14MM47/reading_light/deliverable/07-design-reference/images/moon-lithophane-preview.png

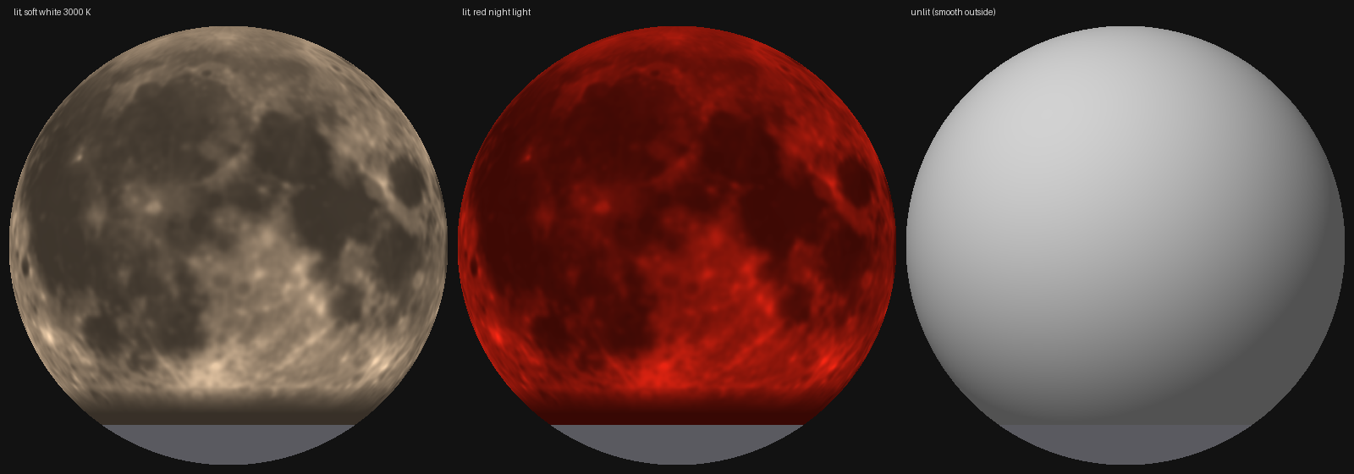
deliverable/07-design-reference/images/moon-lithophane-preview.png
