14MM47/reading_light/deliverable/07-design-reference/README.md

# 07: Design reference

- `led-board-v0.2-and-slim-head-design-note.pdf`: why the LP5012 and the MCP9800, the 18 mm layout, the optics
  correction, the slim head, what changes for the user, cost.
- `electronics-design-notes.pdf`: power path, charger, LED drive, thermal protection, runtimes, I²C.
- `datasheet-key-specs.pdf`: the datasheet values the design relies on, with page references.
- `research-*.pdf`: light modes (melanopic guidance, colour targets), Farnell/RS sourcing, gooseneck, battery and
  PCB pricing.
- `optics/`: `head_v02.py` and its output `head_v02.txt` (v0.2 head, the opening as the aperture), and the round-1
  integrating-sphere results `sphere_illum.*`.
- `handoff-06-thingiverse-survey.pdf`: survey of existing moon models. Not done from the cloud, because the site's
  bot protection blocks automated access.
- `images/moon-lithophane-preview.png`: the NASA-data lithophane, lit.
