14MM47/reading_light/deliverable/07-design-reference/optics/sphere_illum.csv

opening_deg | board_z_mm | dz_mm | max_over_min | flux_to_wall
25.0 | -25.39 | -4.0 | 1.352 | 0.791
25.0 | -24.39 | -3.0 | 1.228 | 0.848
25.0 | -23.39 | -2.0 | 1.062 | 0.91
25.0 | -22.39 | -1.0 | 1.01 | 0.975
25.0 | -21.39 | 0.0 | 1.015 | 1.0
25.0 | -19.89 | 1.5 | 1.393 | 1.0
25.0 | -18.39 | 3.0 | 1.999 | 1.0
25.0 | -15.39 | 6.0 | 2.151 | 1.0
25.0 | -11.39 | 10.0 | 2.413 | 1.0
30.0 | -24.44 | -4.0 | 1.12 | 0.838
30.0 | -23.44 | -3.0 | 1.036 | 0.896
30.0 | -22.44 | -2.0 | 1.005 | 0.95
30.0 | -21.44 | -1.0 | 1.003 | 0.988
30.0 | -20.44 | 0.0 | 1.074 | 1.0
30.0 | -18.94 | 1.5 | 1.427 | 1.0
30.0 | -17.44 | 3.0 | 2.046 | 1.0
30.0 | -14.44 | 6.0 | 2.208 | 1.0
30.0 | -10.44 | 10.0 | 2.49 | 1.0
