14MM47/reading_light/deliverable/00-overview/fitment/fitment_sheet.png

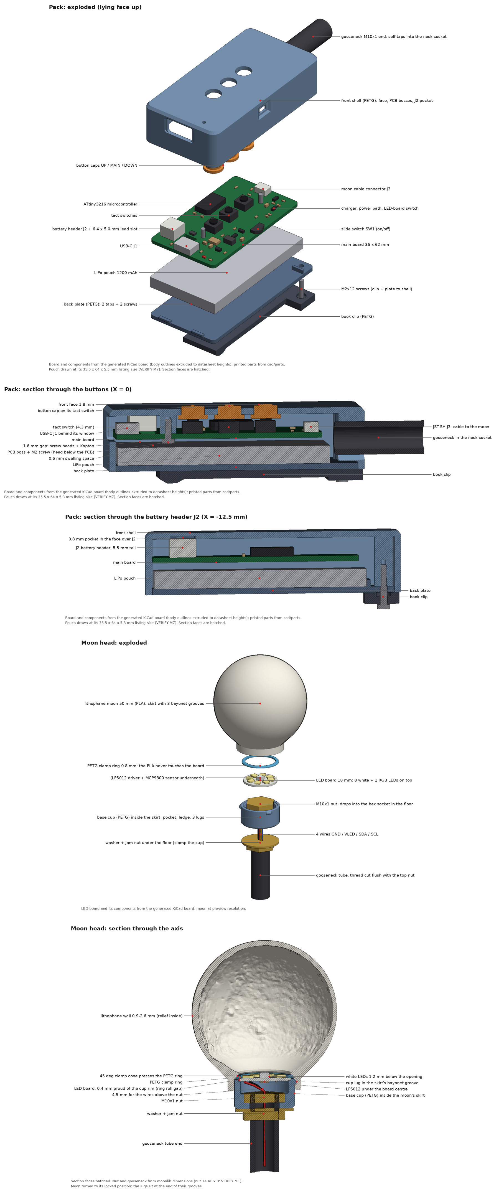
deliverable/00-overview/fitment/fitment_sheet.png
