14MM47/reading_light/deliverable/00-overview/fitment/head_exploded.png

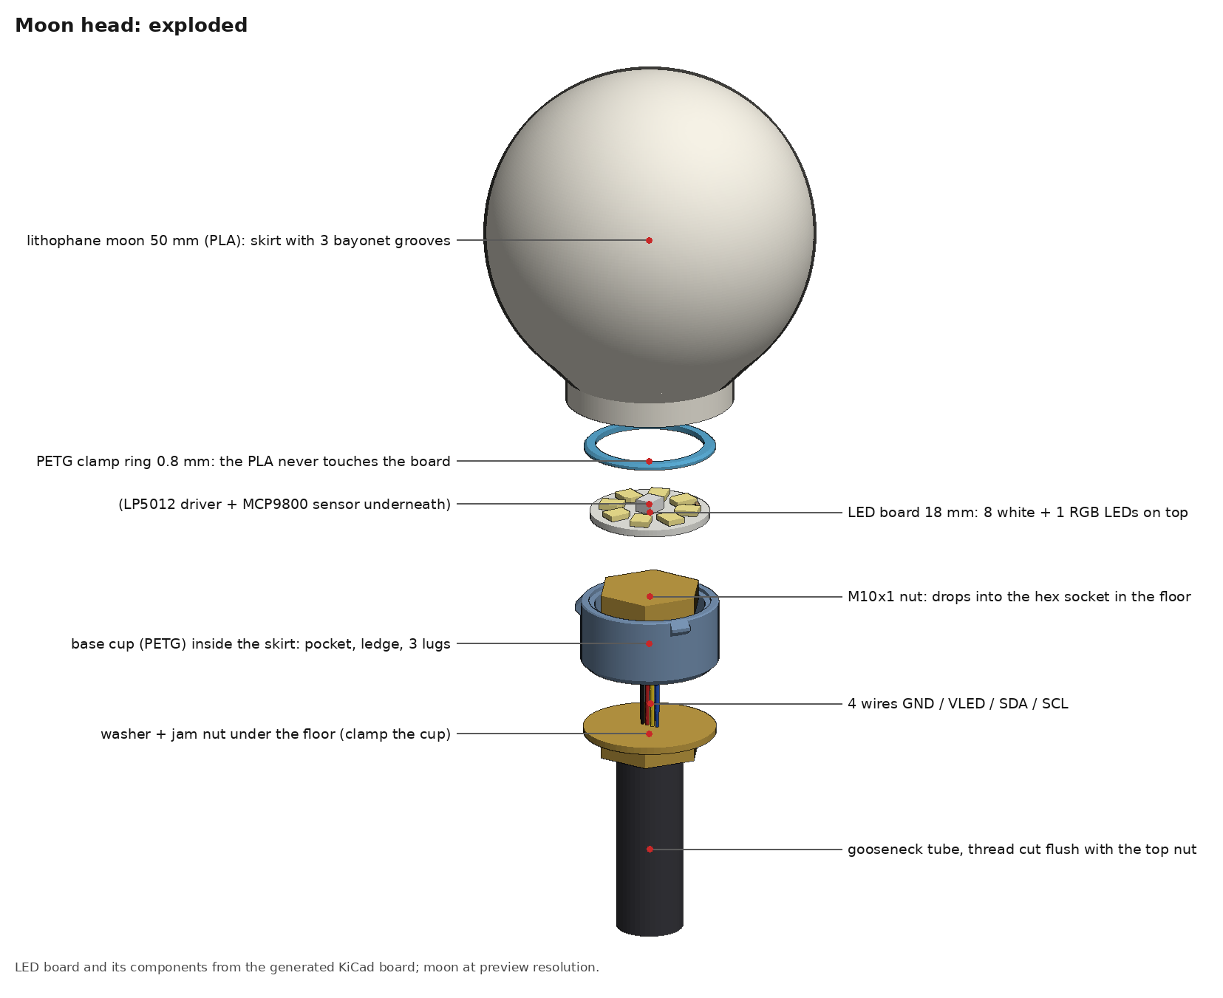
deliverable/00-overview/fitment/head_exploded.png
