14MM47/reading_light/deliverable/00-overview/fitment/pack_section_buttons.png

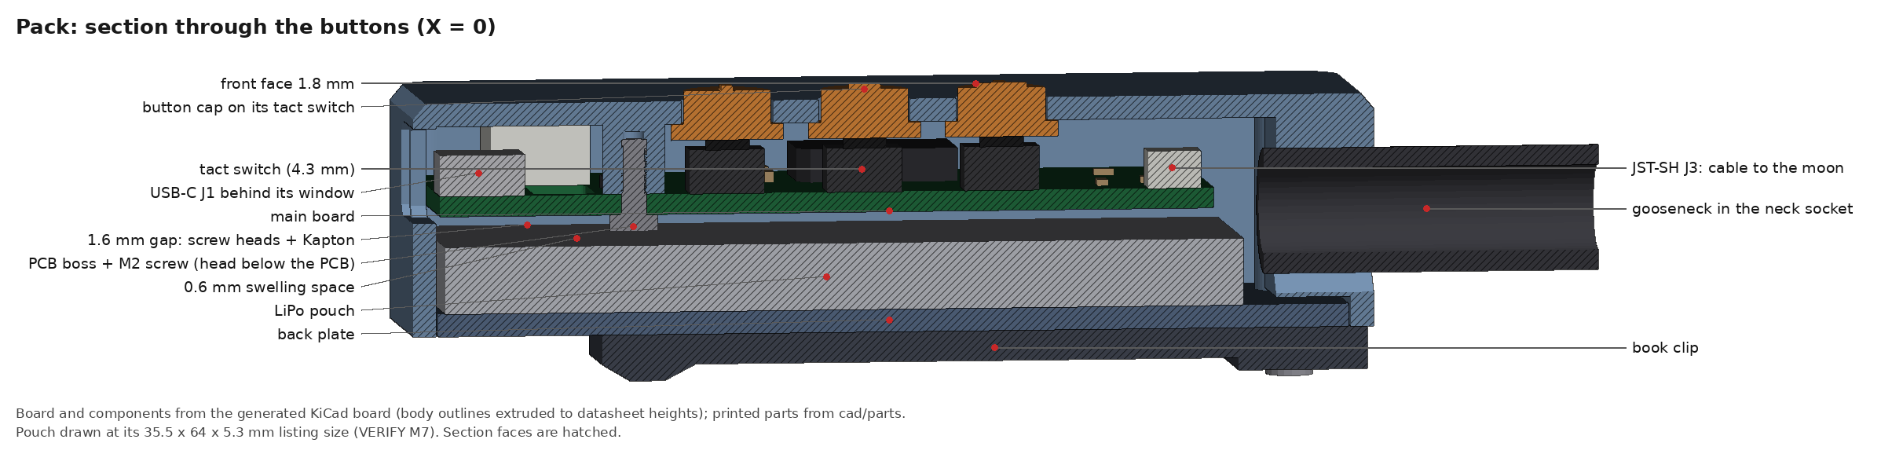
deliverable/00-overview/fitment/pack_section_buttons.png
