14MM47/reading_light/fab/led-board/v0.2/renders/led-board_bottom.png

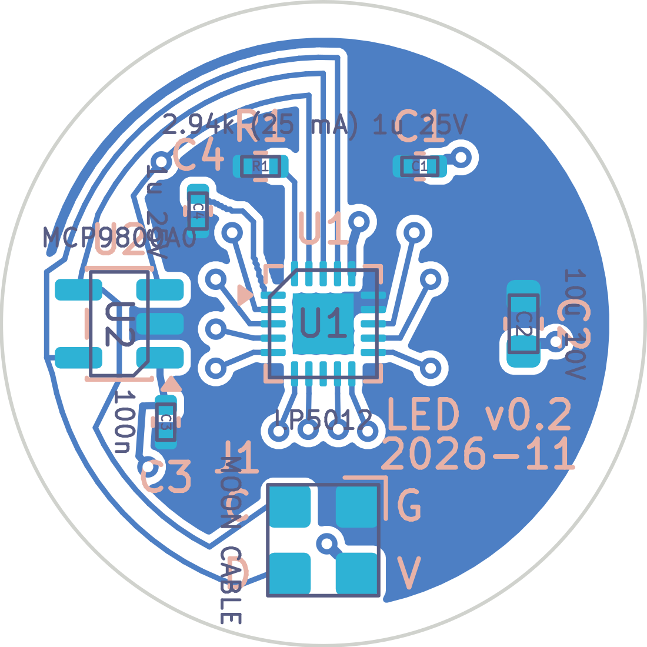
fab/led-board/v0.2/renders/led-board_bottom.png
