14MM47/reading_light/bom/BOM.csv

Key | Qty per lamp | References | Value | Manufacturer | MPN | Description | Footprint | Farnell | Datasheet
USBC | 1 | main:J1 | USB4125-GF-A | GCT | USB4125-GF-A | USB-C receptacle, 6-pin power only, top mount, SMT + THT shell | USB_C_Receptacle_GCT_USB4125-xx-x_6P_TopMnt_Horizontal | 3648642 | https://gct.co/files/drawings/usb4125.pdf
PTC | 1 | main:F1 | 1.1A PTC | Bourns | MF-MSMF110/16X-2 | Resettable fuse 1.1 A hold / 2.2 A trip, 16 V, 0.06-0.20 Ohm, 1812 (VBUS: limits a short in the neck cable on USB; 0.75 A part had too little hold margin when warm, round2 R2-E3) | Fuse_1812_4532Metric |  | https://www.bourns.com/docs/Product-Datasheets/mf-msmf.pdf
R_5K1 | 2 | main:R1 main:R2 | 5.1k | Multicomp Pro | MCWR06X5101FTL | Resistor 5.1 kOhm 1% 0603 | R_0603_1608Metric
TVS | 1 | main:D1 | SMF5.0A | Littelfuse | SMF5.0A | TVS unidirectional 5.0 V standoff, 200 W, SOD-123FL | D_SOD-123F | 2691565 | https://www.littelfuse.com/products/tvs-diodes/surface-mount/smf.aspx
C_10U | 4 | main:C1 main:C2 main:C3 main:C4 | 10u 16V 0805 | Samsung | CL21A106KOQNNNE | MLCC 10 uF 16 V X5R 0805 (0603 10 V part keeps only 2.9 uF at 5 V) | C_0805_2012Metric
CHG | 1 | main:U1 | MCP73831-2ACI/OT | Microchip | MCP73831T-2ACI/OT | Li-ion/LiPo linear charger 4.20 V, up to 500 mA, SOT-23-5 | SOT-23-5 | 1332158 | https://ww1.microchip.com/downloads/aemDocuments/documents/APID/ProductDocuments/DataSheets/MCP73831-Family-Data-Sheet-DS20001984H.pdf
R_3K9 | 1 | main:R3 | 3.9k | Multicomp Pro | MCWR06X3901FTL | Resistor 3.9 kOhm 1% 0603 (charge current 256 mA) | R_0603_1608Metric
R_1K | 2 | main:R4 main:R11 | 1k | Multicomp Pro | MCWR06X1001FTL | Resistor 1 kOhm 1% 0603 | R_0603_1608Metric
LED_RED_0603 | 1 | main:D2 | red | Kingbright | APT1608SURCK | Hyper-red chip LED 0603, 230 mcd @ 20 mA, pin 1 = K (charge indicator, ~3 mA) | LED_0603_1608Metric |  | https://www.kingbrightusa.com/images/catalog/SPEC/APT1608SURCK.pdf
JST_PH2 | 1 | main:J2 | S2B-PH-SM4-TB | JST | S2B-PH-SM4-TB(LF)(SN) | JST PH 2-pin side-entry SMD header (battery) | JST_PH_S2B-PH-SM4-TB_1x02-1MP_P2.00mm_Horizontal | 9492615
PFET | 4 | main:Q3 main:Q1 main:Q2 main:Q4 | DMG2305UX | Diodes Inc | DMG2305UX-7 | P-MOSFET -20 V -4.2 A, Rds(on) 52 mOhm @ -4.5 V (max), SOT-23 (G=1 S=2 D=3) | SOT-23 | 2543533 | https://www.diodes.com/assets/Datasheets/DMG2305UX.pdf
R_10K | 4 | main:R10 main:R5 main:R7 main:R13 | 10k | Multicomp Pro | MCWR06X1002FTL | Resistor 10 kOhm 1% 0603 | R_0603_1608Metric | 2447230
RECT | 1 | main:D3 | S1J | Vishay | S1J-E3/61T | Silicon rectifier 1 A 600 V, SMA (DO-214AC); Vf ~0.85 V @ 0.3 A; leakage nA at 4 V reverse (USB -> VSYS OR-ing) | D_SMA |  | https://www.vishay.com/docs/88711/s1a.pdf
R_1M | 1 | main:R6 | 1M | Multicomp Pro | MCWR06X1004FTL | Resistor 1 MOhm 1% 0603 | R_0603_1608Metric
C_100N | 3 | main:C5 main:C6 main:C8 | 100n | Multicomp Pro | MC0603B104K500CT | MLCC 100 nF 50 V X7R 0603 | C_0603_1608Metric | 1759122
SLIDE | 1 | main:SW1 | PCM12SMTR | C&K | PCM12SMTR | Mini slide switch SPDT, right-angle SMD (side actuated) | SW_SPDT_PCM12 | 9575146
MCU | 1 | main:U2 | ATtiny3216-SN | Microchip | ATTINY3216-SN | 8-bit AVR MCU, 32 KB flash, 256 B EEPROM, UPDI, 1.8-5.5 V, SOIC-20 (300 mil) | SOIC-20W_7.5x12.8mm_P1.27mm | 3018703 | https://ww1.microchip.com/downloads/aemDocuments/documents/MCU08/ProductDocuments/DataSheets/ATtiny3216-17-DataSheet-DS40002205A.pdf
C_1U | 1 | main:C7 | 1u | Samsung | CL10A105KB8NNNC | MLCC 1 uF 50 V X5R 0603 | C_0603_1608Metric | 3013385
TACT | 3 | main:SW2 main:SW3 main:SW4 | PTS645SM43SMTR92 | C&K | PTS645SM43SMTR92 LFS | Tactile switch 6x6x4.3 mm SMD, 160 gf | SW_SPST_PTS645Sx43SMTR92 | 3941596
R_100K | 1 | main:R12 | 100k | Multicomp Pro | MCWR06X1003FTL | Resistor 100 kOhm 1% 0603 | R_0603_1608Metric
R_3K3 | 2 | main:R8 main:R9 | 3.3k | Multicomp Pro | MCWR06X3301FTL | Resistor 3.3 kOhm 1% 0603 (I2C pull-up) | R_0603_1608Metric
JST_SH4 | 1 | main:J3 | SM04B-SRSS-TB | JST | SM04B-SRSS-TB(LF)(SN) | JST SH 4-pin side-entry SMD header (Qwiic pinout, moon cable) | JST_SH_SM04B-SRSS-TB_1x04-1MP_P1.00mm_Horizontal | 1830839
LED_WW | 4 | led:D1 led:D3 led:D5 led:D7 | 2700K CRI97 | Bridgelux | BXEN-27S-11M-3C-00-0-3 | Mid-power white LED 2835, 2700 K, CRI 97 (Thrive), 3 V class | LED_PLCC_2835_Dense | 3498849
LED_CW | 4 | led:D2 led:D4 led:D6 led:D8 | 5000K CRI97 | Bridgelux | BXEN-50S-11M-3C-00-0-3 | Mid-power white LED 2835, 5000 K, CRI 97 (Thrive), 3 V class | LED_PLCC_2835_Dense | 3498853
LED_RGB | 1 | led:D9 | RGB 3528 CA | Wurth Elektronik | 150141M173100 | RGB LED PLCC-4 3528, common anode (1 A, 2 B-K, 3 R-K, 4 G-K), 30 mA max/die, R 625 / G 520 / B 470 nm | LED_RGB_Wuerth-PLCC4_3.2x2.8mm_150141M173100 | 2322115 | https://www.we-online.com/components/products/datasheet/150141M173100.pdf
LEDDRV | 1 | led:U1 | LP5012RUKR | Texas Instruments | LP5012RUKR | 12-ch I2C constant-current RGB LED sink driver, 25.5 mA max, 12-bit (9+3 dither) 29 kHz PWM, WQFN-20 3x3 0.4 mm pitch | Texas_RUK0020B_WQFN-20-1EP_3x3mm_P0.4mm_EP1.7x1.7mm |  | https://www.ti.com/lit/ds/symlink/lp5012.pdf
R_2K94_0402 | 1 | led:R1 | 2.94k | Yageo | RC0402FR-072K94L | Resistor 2.94 kOhm 1% 0402 (LP5012 RIREF: 105 x 0.7 V / 2.94 k = 25.0 mA/channel) | R_0402_1005Metric
C_1U_0402 | 2 | led:C1 led:C4 | 1u 25V | Murata | GRM155R61E105KA12D | MLCC 1 uF 25 V X5R 0402 (LP5012 VCC / VCAP) | C_0402_1005Metric
C_10U_0603 | 1 | led:C2 | 10u 10V | Murata | GRM188R61A106KE69D | MLCC 10 uF 10 V X5R 0603 (LED board bulk) | C_0603_1608Metric
TEMP | 1 | led:U2 | MCP9800A0 | Microchip | MCP9800A0T-M/OT | I2C temperature sensor, LM75 register compatible (8-bit CONFIG), address 0x48, 2.7-5.5 V, open-drain ALERT, +/-0.5 C typ, +/-1 C max (-10..85 C), SOT-23-5 | SOT-23-5 | 1439485 | https://ww1.microchip.com/downloads/en/DeviceDoc/21909d.pdf
R_2K4_0402 | 1 | led:R2 | 2.4k | Yageo | RC0402FR-072K4L | Resistor 2.4 kOhm 1% 0402 (LP5012 EN pull-up) | R_0402_1005Metric
C_100N_0402 | 1 | led:C3 | 100n | Murata | GRM155R71C104KA88D | MLCC 100 nF 16 V X7R 0402 | C_0402_1005Metric
OTHER | 1 |  |  | Pimoroni | BAT0004 | LiPo pouch 3.7 V 1200 mAh, protected, JST-PH 2.0 lead (64 x 35.5 x 5.3 mm) |  |  | https://shop.pimoroni.com/products/lipo-battery-pack
OTHER | 1 |  |  | Amazon UK (PATIKIL 4.7in M10 gooseneck) | search: PATIKIL gooseneck M10 120mm | Gooseneck 120 mm, 10 mm OD, M10x1 male ends, hollow (6.8 mm bore)
OTHER | 1 |  |  | Amazon UK / eBay (food-grade silicone tube) | 10x12mm silicone tube 1 m | Silicone tube 10 mm ID x 12 mm OD, 150 mm (sleeve for the gooseneck: the plastic-coated finish)
OTHER | 2 |  |  | Lamp Spares UK / any lamp-parts shop | M10x1 lamp nut | M10x1 brass hex nut, ~14 mm AF, 3 mm thick (moon base: one in the cup's socket, one jam nut under the floor)
OTHER | 1 |  |  | Lamp Spares UK / Accu.co.uk | M10 washer (lamp) or M10 form A | M10 flat washer, <= 20 mm OD, ~1 mm thick (under the cup floor, above the jam nut)
OTHER | 1 |  |  | RS Components | 288-4665 (SparkFun KIT-15081 Qwiic cable kit, 50-500 mm) | Qwiic / STEMMA QT 4-pin JST-SH cable >= 200 mm (cut one end; bare end solders to the LED board) |  |  | https://uk.rs-online.com/web/p/cable-assemblies/2884665
OTHER | 2 |  |  | Amazon/Accu.co.uk | M2x6 self tapping pan head A2 | M2 x 6 mm self-tapping pan-head screws (PCB to front shell)
OTHER | 2 |  |  | Amazon/Accu.co.uk | M2x12 self tapping pan head A2 | M2 x 12 mm self-tapping pan-head screws (clip + back plate to front shell)
OTHER | 1 |  |  | Bambu Lab (PLA Basic Jade White, PETG Basic) |  | Filament: white PLA (moon) ~12 g, PETG (base, pack, clip, caps) ~40 g
OTHER | 0 |  |  | any |  | Cyanoacrylate (super glue, gel) for the gooseneck ends and the LED-pad strain relief
OTHER | 0 |  |  | any |  | Neutral-cure silicone (or E6000): strain relief over the LED-board wire joints and the cable at J3
OTHER | 1 |  |  | Amazon UK / 3D-printer spares | PTFE tube 2x3mm | PTFE tube 2 mm ID x 3 mm OD (or silicone sleeve), 200 mm: protects the cable inside the gooseneck
OTHER | 0 |  |  | any |  | Kapton (polyimide) tape 10-20 mm: over the pouch under the PCB, under U1/D3/Q1-Q3, and a disc over the LED board's LP5012 (faces the gooseneck's metal end)
OTHER | 0 |  |  | any |  | USB-C charger >= 1 A at 5 V (if you don't have one)
