14MM47/reading_light/deliverable/02-parts-order/digikey_order.csv

Supplier | Order code / search | Manufacturer Part Number | Manufacturer | Quantity | Needed for builds | Indicative unit GBP (ex VAT) | Indicative line GBP | Description
DigiKey UK | LP5012RUKR (cut tape) - digikey.co.uk | LP5012RUKR | Texas Instruments | 3 | 2 | 0.900 | 2.70 | 12-ch I2C constant-current RGB LED sink driver, 25.5 mA max, 12-bit (9+3 dither) 29 kHz PWM, WQFN-20 3x3 0.4 mm pitch
