14MM47/reading_light/deliverable/01-pcb-manufacture/main-board/main-board.step

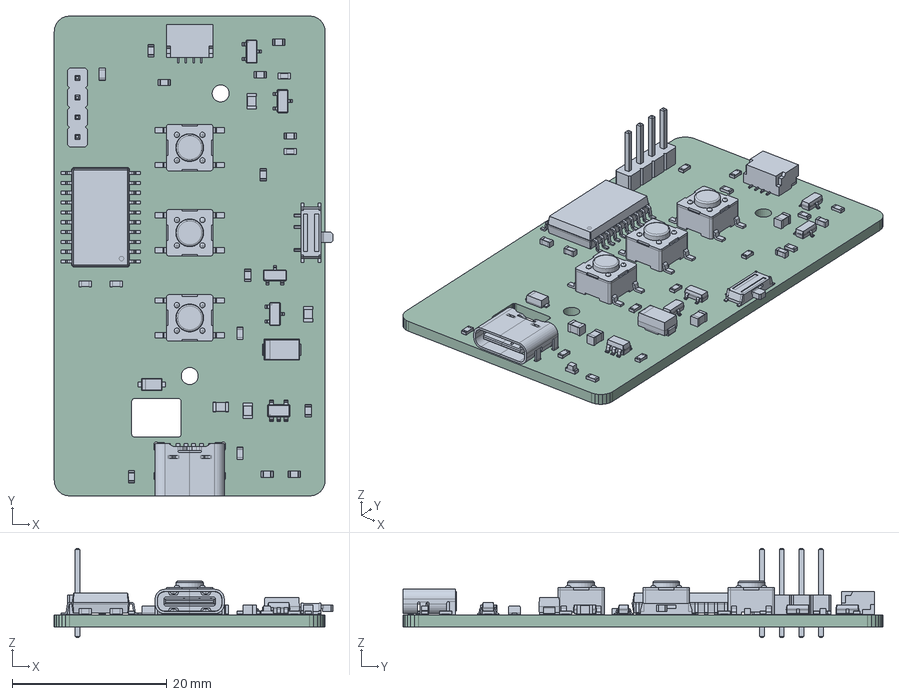
[picture p16: CAD file, 2026-11-02]
deliverable/01-pcb-manufacture/main-board/main-board.step
36.0 x 62.0 x 11.5 mm
SOT-23 x 4
C_0805_2012Metric x 4
SW_SPST_PTS645Sx43SMTR92 x 3
JST_SH_SM04B-SRSS-TB_1x04-1MP_P1.00mm_Horizontal
R_0603_1608Metric x 13
C_0603_1608Metric x 4
D_SMA
SW_SPDT_PCM12
SOIC-20W_7.5x12.8mm_P1.27mm
USB_C_Receptacle_GCT_USB4125-xx-x_6P_TopMnt_Horizontal
SOT-23-5
PinHeader_1x04_P2.54mm_Vertical
D_SOD-123F
LED_0603_1608Metric
main-board_PCB
