14MM47/reading_light/deliverable/01-pcb-manufacture/led-board/led-board.step

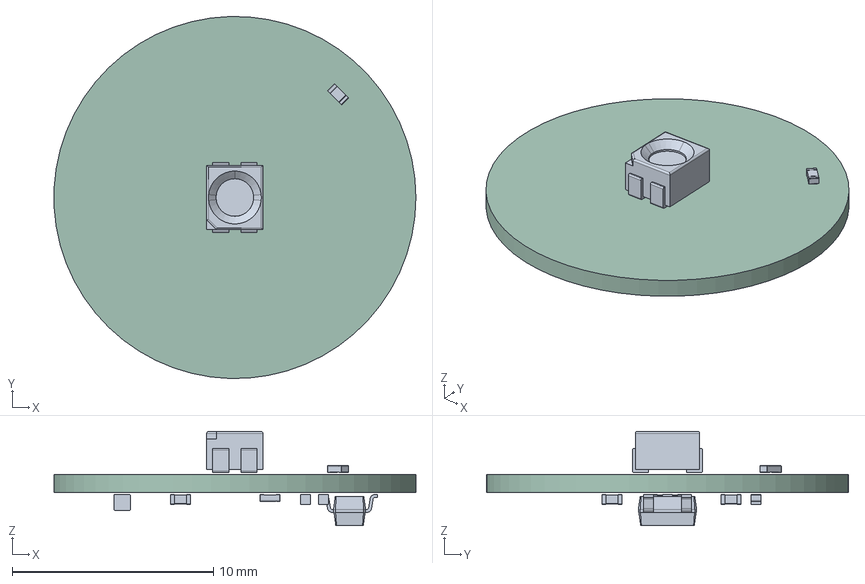
[picture p17: CAD file, 2026-11-04]
deliverable/01-pcb-manufacture/led-board/led-board.step
18.0 x 18.0 x 4.68 mm
R_0402_1005Metric x 2
LED_RGB_Wuerth-PLCC4_3.2x2.8mm_150141M173100
C_0603_1608Metric
C_0402_1005Metric x 3
SOT-23-5
led-board_PCB
