14MM47/reading_light/deliverable/03-3d-printing/1-coupons-print-first/coupon_litho_wedge.3mf

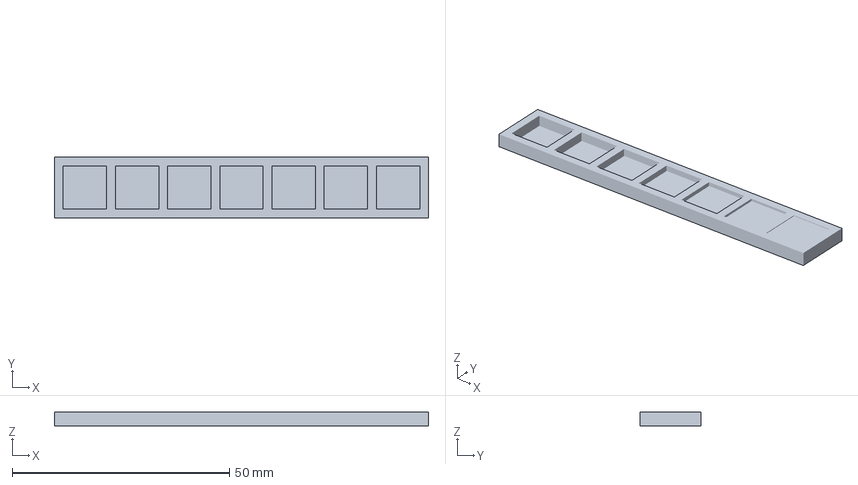
[picture p18: CAD file, 2026-11-04]
deliverable/03-3d-printing/1-coupons-print-first/coupon_litho_wedge.3mf
86.0 x 14.0 x 3.20 mm
