14MM47/reading_light/deliverable/03-3d-printing/2-moon-head/moon_base.3mf

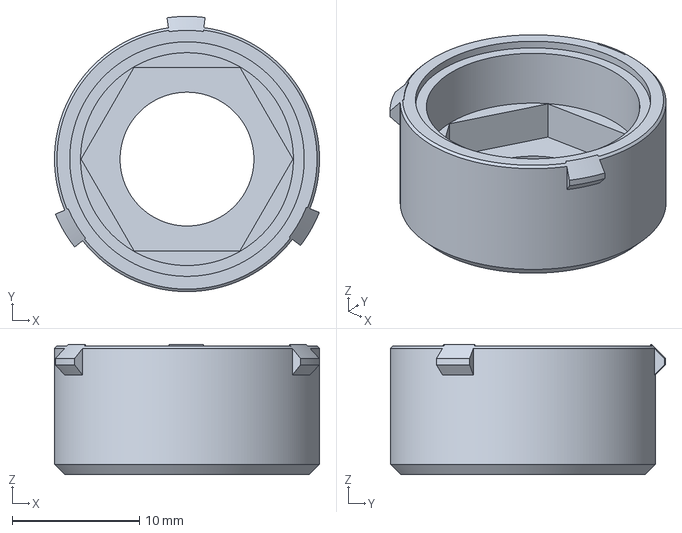
[picture p19: CAD file, 2026-11-04]
deliverable/03-3d-printing/2-moon-head/moon_base.3mf
20.8 x 21.6 x 10.2 mm
