14MM47/reading_light/deliverable/03-3d-printing/3-pack/pack_clip.3mf

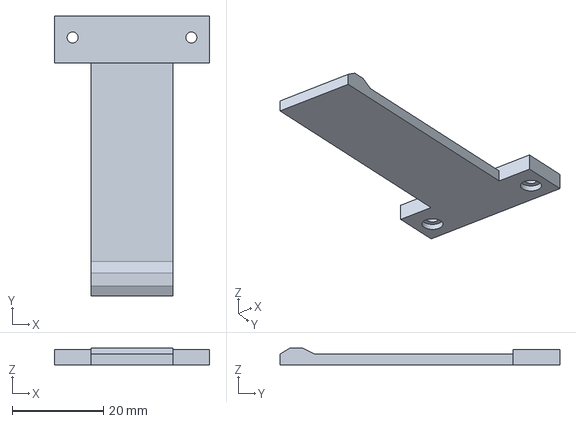
[picture p20: CAD file, 2026-11-04]
deliverable/03-3d-printing/3-pack/pack_clip.3mf
34.0 x 61.3 x 3.70 mm
