14MM47/reading_light/deliverable/03-3d-printing/4-assembly-jig/jig_led_board.3mf

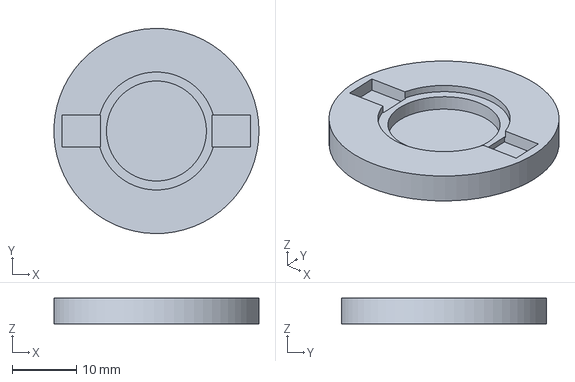
[picture p21: CAD file, 2026-11-04]
deliverable/03-3d-printing/4-assembly-jig/jig_led_board.3mf
32.0 x 32.0 x 4.00 mm
