14MM47/reading_light/deliverable/03-3d-printing/1-coupons-print-first/coupon_bayonet_cup.3mf

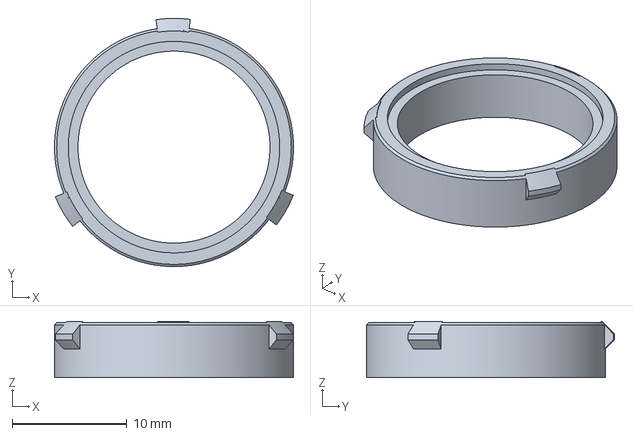
[picture p22: CAD file, 2026-11-04]
deliverable/03-3d-printing/1-coupons-print-first/coupon_bayonet_cup.3mf
20.8 x 21.6 x 4.89 mm
