14MM47/reading_light/deliverable/03-3d-printing/2-moon-head/moon_shell.3mf

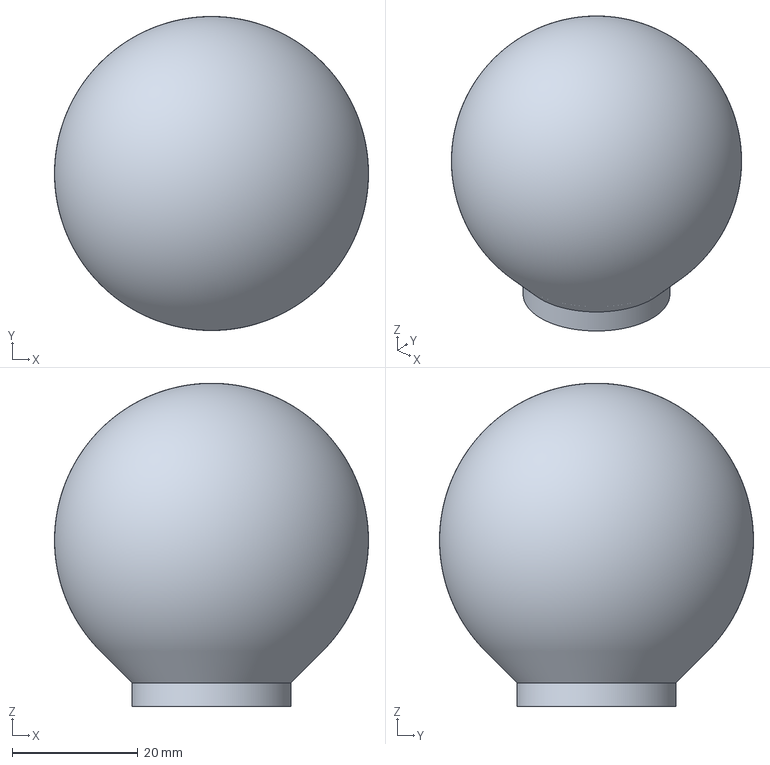
[picture p23: CAD file, 2026-11-04]
deliverable/03-3d-printing/2-moon-head/moon_shell.3mf
50.0 x 50.0 x 51.5 mm
