14MM47/reading_light/deliverable/03-3d-printing/3-pack/pack_front.3mf

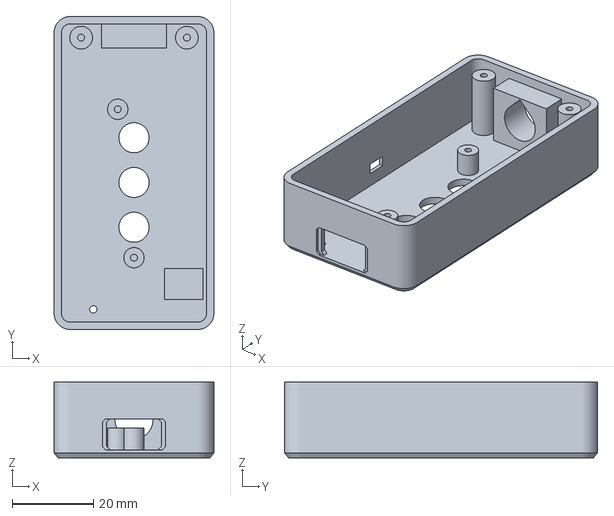
[picture p24: CAD file, 2026-11-04]
deliverable/03-3d-printing/3-pack/pack_front.3mf
39.3 x 77.0 x 18.6 mm
