14MM47/reading_light/print/coupon_fit.3mf

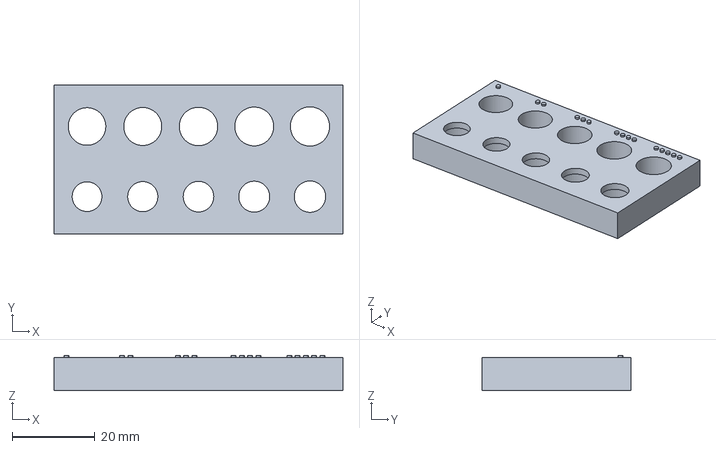
[picture p25: CAD file, 2026-11-04]
print/coupon_fit.3mf
70.0 x 36.0 x 8.50 mm
