14MM47/reading_light/deliverable/03-3d-printing/1-coupons-print-first/coupon_bayonet_skirt.3mf

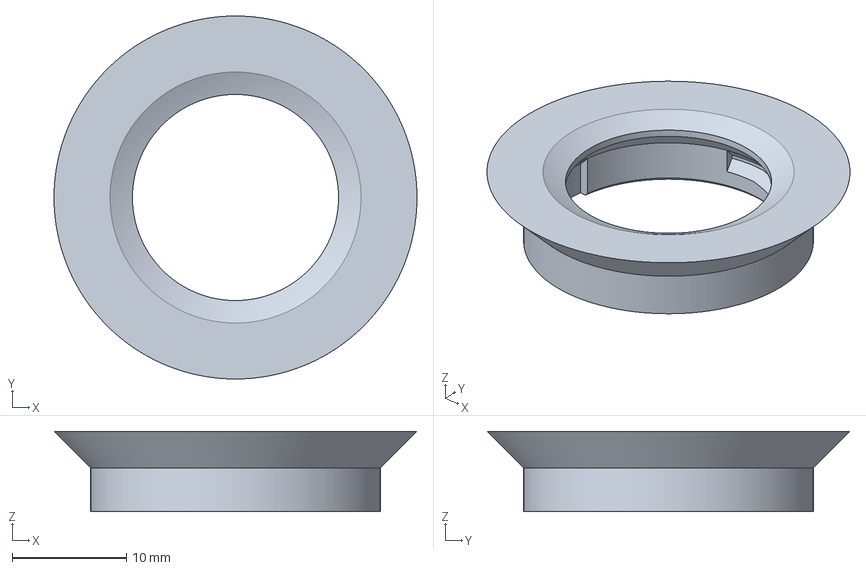
[picture p26: CAD file, 2026-11-04]
deliverable/03-3d-printing/1-coupons-print-first/coupon_bayonet_skirt.3mf
31.7 x 31.7 x 6.99 mm
