14MM47/reading_light/deliverable/03-3d-printing/2-moon-head/moon_ring.3mf

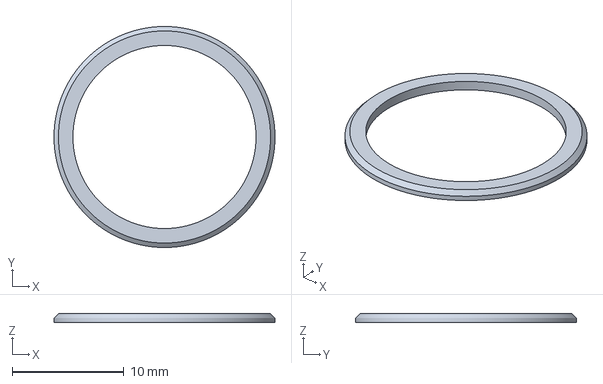
[picture p27: CAD file, 2026-11-04]
deliverable/03-3d-printing/2-moon-head/moon_ring.3mf
19.8 x 19.8 x 0.8 mm
