14MM47/reading_light/deliverable/03-3d-printing/3-pack/button_caps.3mf

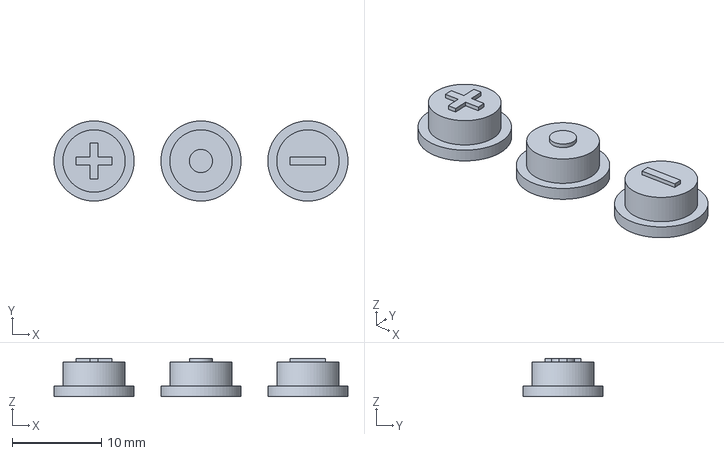
[picture p28: CAD file, 2026-11-04]
deliverable/03-3d-printing/3-pack/button_caps.3mf
33.0 x 9.00 x 4.30 mm
