14MM47/reading_light/deliverable/03-3d-printing/3-pack/pack_back.3mf

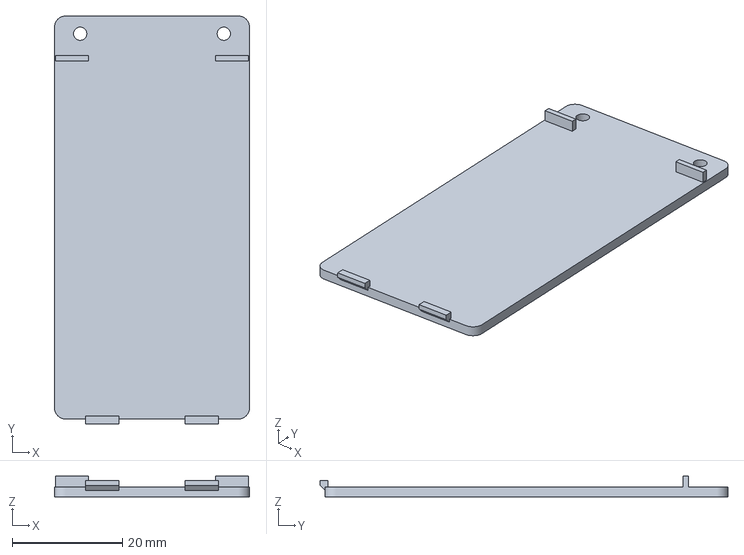
[picture p29: CAD file, 2026-11-04]
deliverable/03-3d-printing/3-pack/pack_back.3mf
35.3 x 73.8 x 3.80 mm
