14MM47/reading_light/(list of files, cad)

Other CAD files:
deliverable/03-3d-printing/1-coupons-print-first/coupon_bayonet_cup.stl
deliverable/03-3d-printing/1-coupons-print-first/coupon_bayonet_skirt.stl
deliverable/03-3d-printing/1-coupons-print-first/coupon_fit.stl
deliverable/03-3d-printing/1-coupons-print-first/coupon_litho_wedge.stl
deliverable/03-3d-printing/2-moon-head/moon_base.stl
deliverable/03-3d-printing/2-moon-head/moon_ring.stl
deliverable/03-3d-printing/2-moon-head/moon_shell.stl
deliverable/03-3d-printing/3-pack/button_caps.stl
deliverable/03-3d-printing/3-pack/pack_back.stl
deliverable/03-3d-printing/3-pack/pack_clip.stl
deliverable/03-3d-printing/3-pack/pack_front.stl
deliverable/03-3d-printing/4-assembly-jig/jig_led_board.stl
print/jig_led_board.stl
print/moon_base.stl
print/moon_ring.stl
print/moon_shell.stl
