14MM47/reading_light/deliverable/00-overview/lamp-assembly-render.png

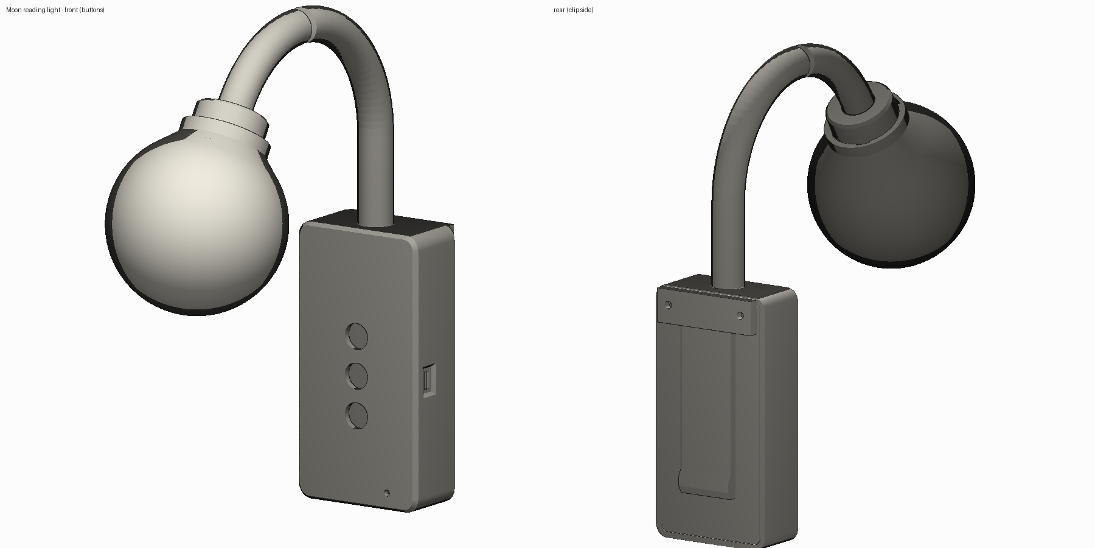
deliverable/00-overview/lamp-assembly-render.png
