14MM47/reading_light/deliverable/01-pcb-manufacture/main-board/images/main-board_top.png

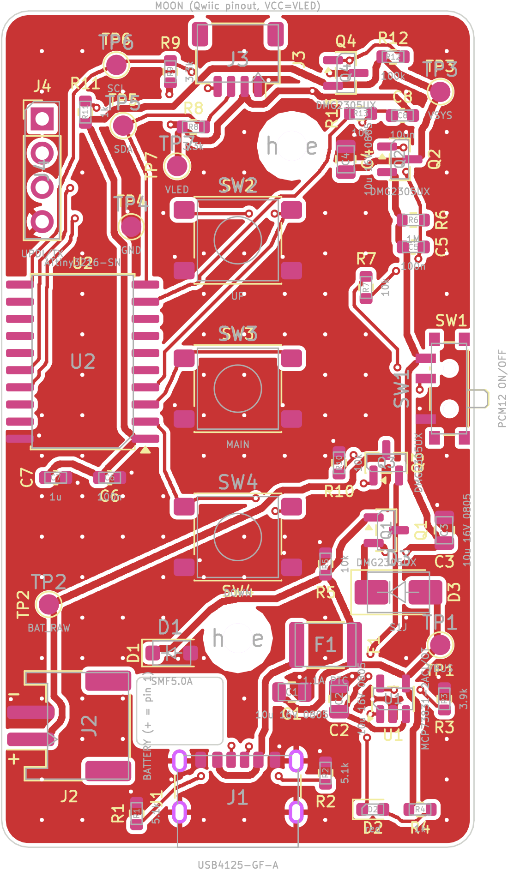
deliverable/01-pcb-manufacture/main-board/images/main-board_top.png
