14MM47/reading_light/deliverable/03-3d-printing/1-coupons-print-first/coupon_litho_wedge-preview.png

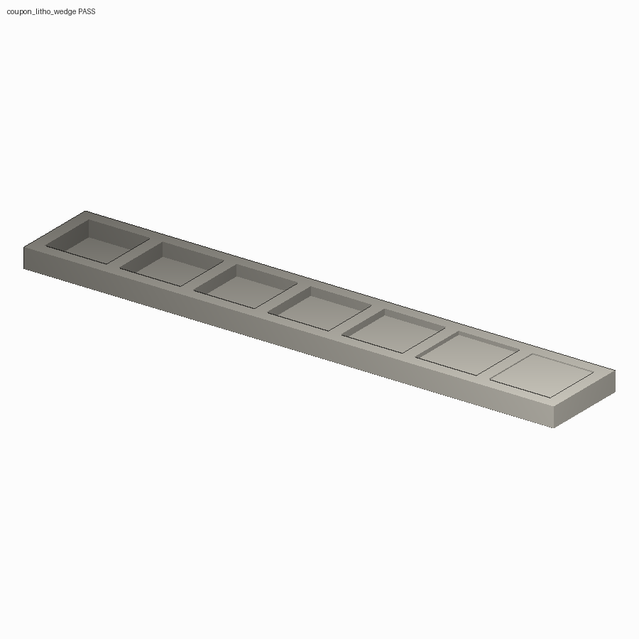
deliverable/03-3d-printing/1-coupons-print-first/coupon_litho_wedge-preview.png
