14MM47/reading_light/deliverable/03-3d-printing/2-moon-head/moon_ring-preview.png

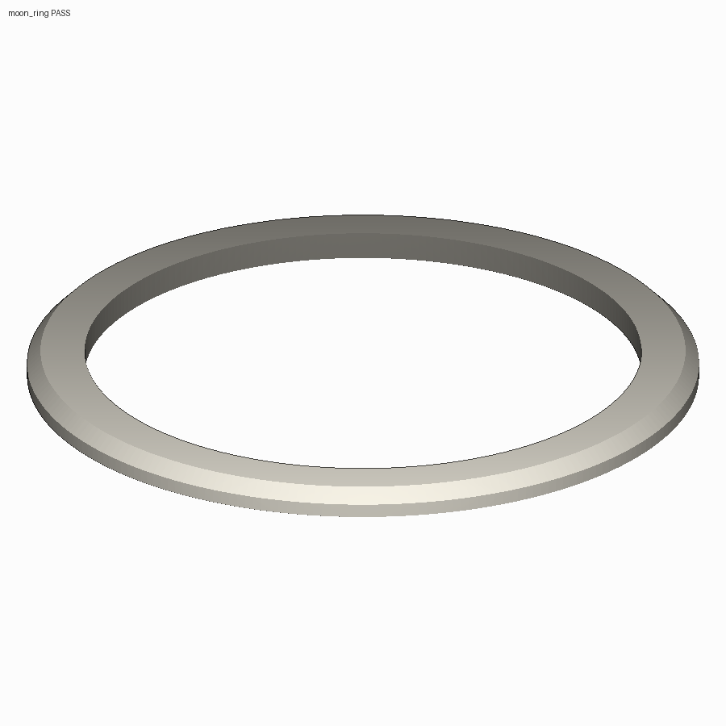
deliverable/03-3d-printing/2-moon-head/moon_ring-preview.png
