14MM47/reading_light/deliverable/03-3d-printing/3-pack/pack_clip-preview.png

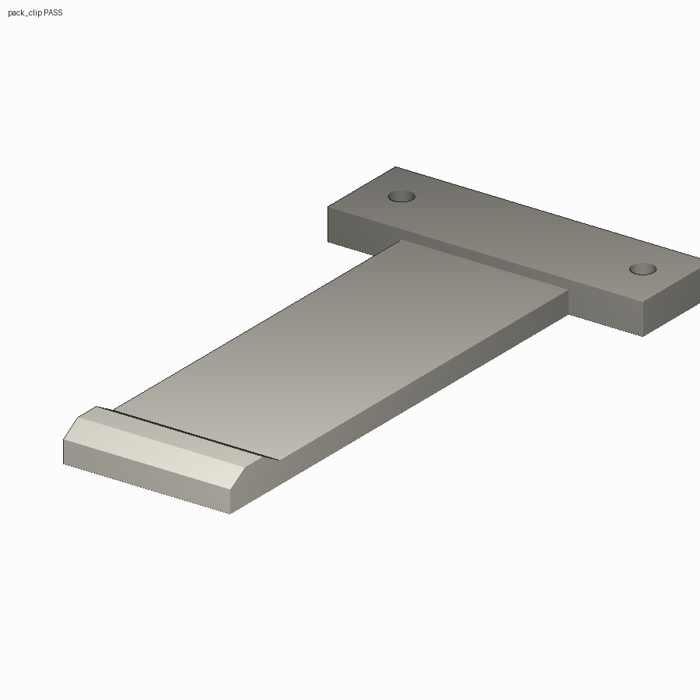
deliverable/03-3d-printing/3-pack/pack_clip-preview.png
