14MM47/reading_light/deliverable/03-3d-printing/4-assembly-jig/jig_led_board-preview.png

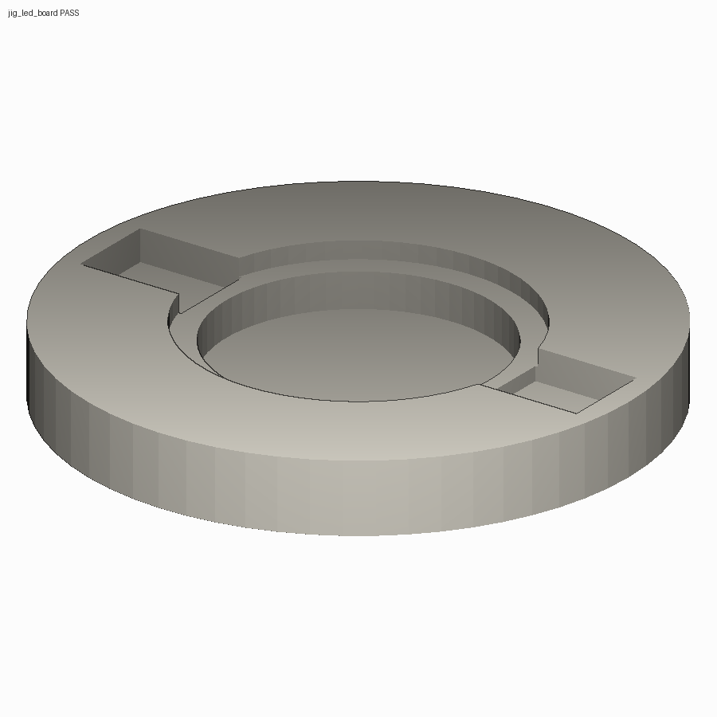
deliverable/03-3d-printing/4-assembly-jig/jig_led_board-preview.png
