14MM47/reading_light/deliverable/05-assembly-and-bring-up/drawings/main-board_assembly_top-zoomed.png

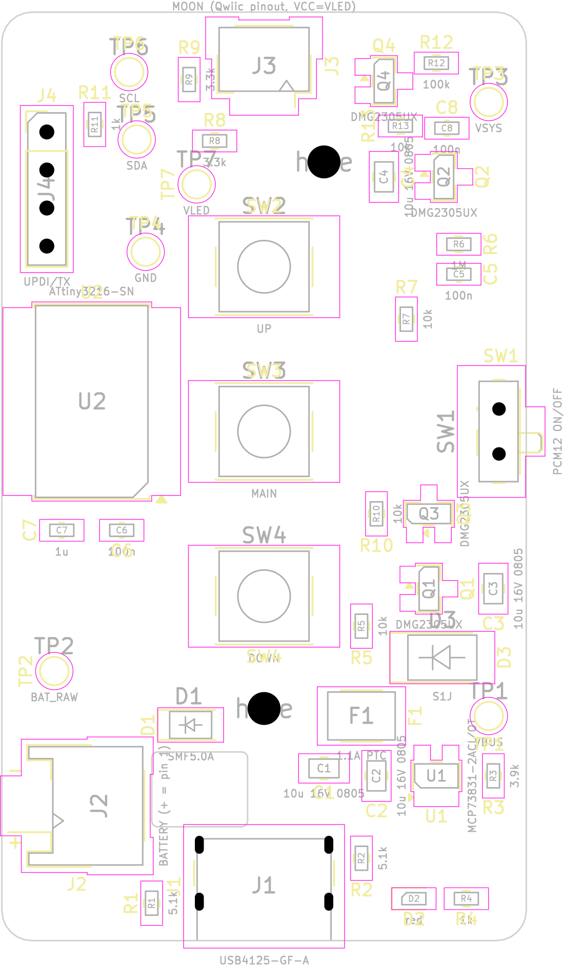
deliverable/05-assembly-and-bring-up/drawings/main-board_assembly_top-zoomed.png
