14MM47/reading_light/deliverable/01-pcb-manufacture/led-board/led-board-schematic.pdf

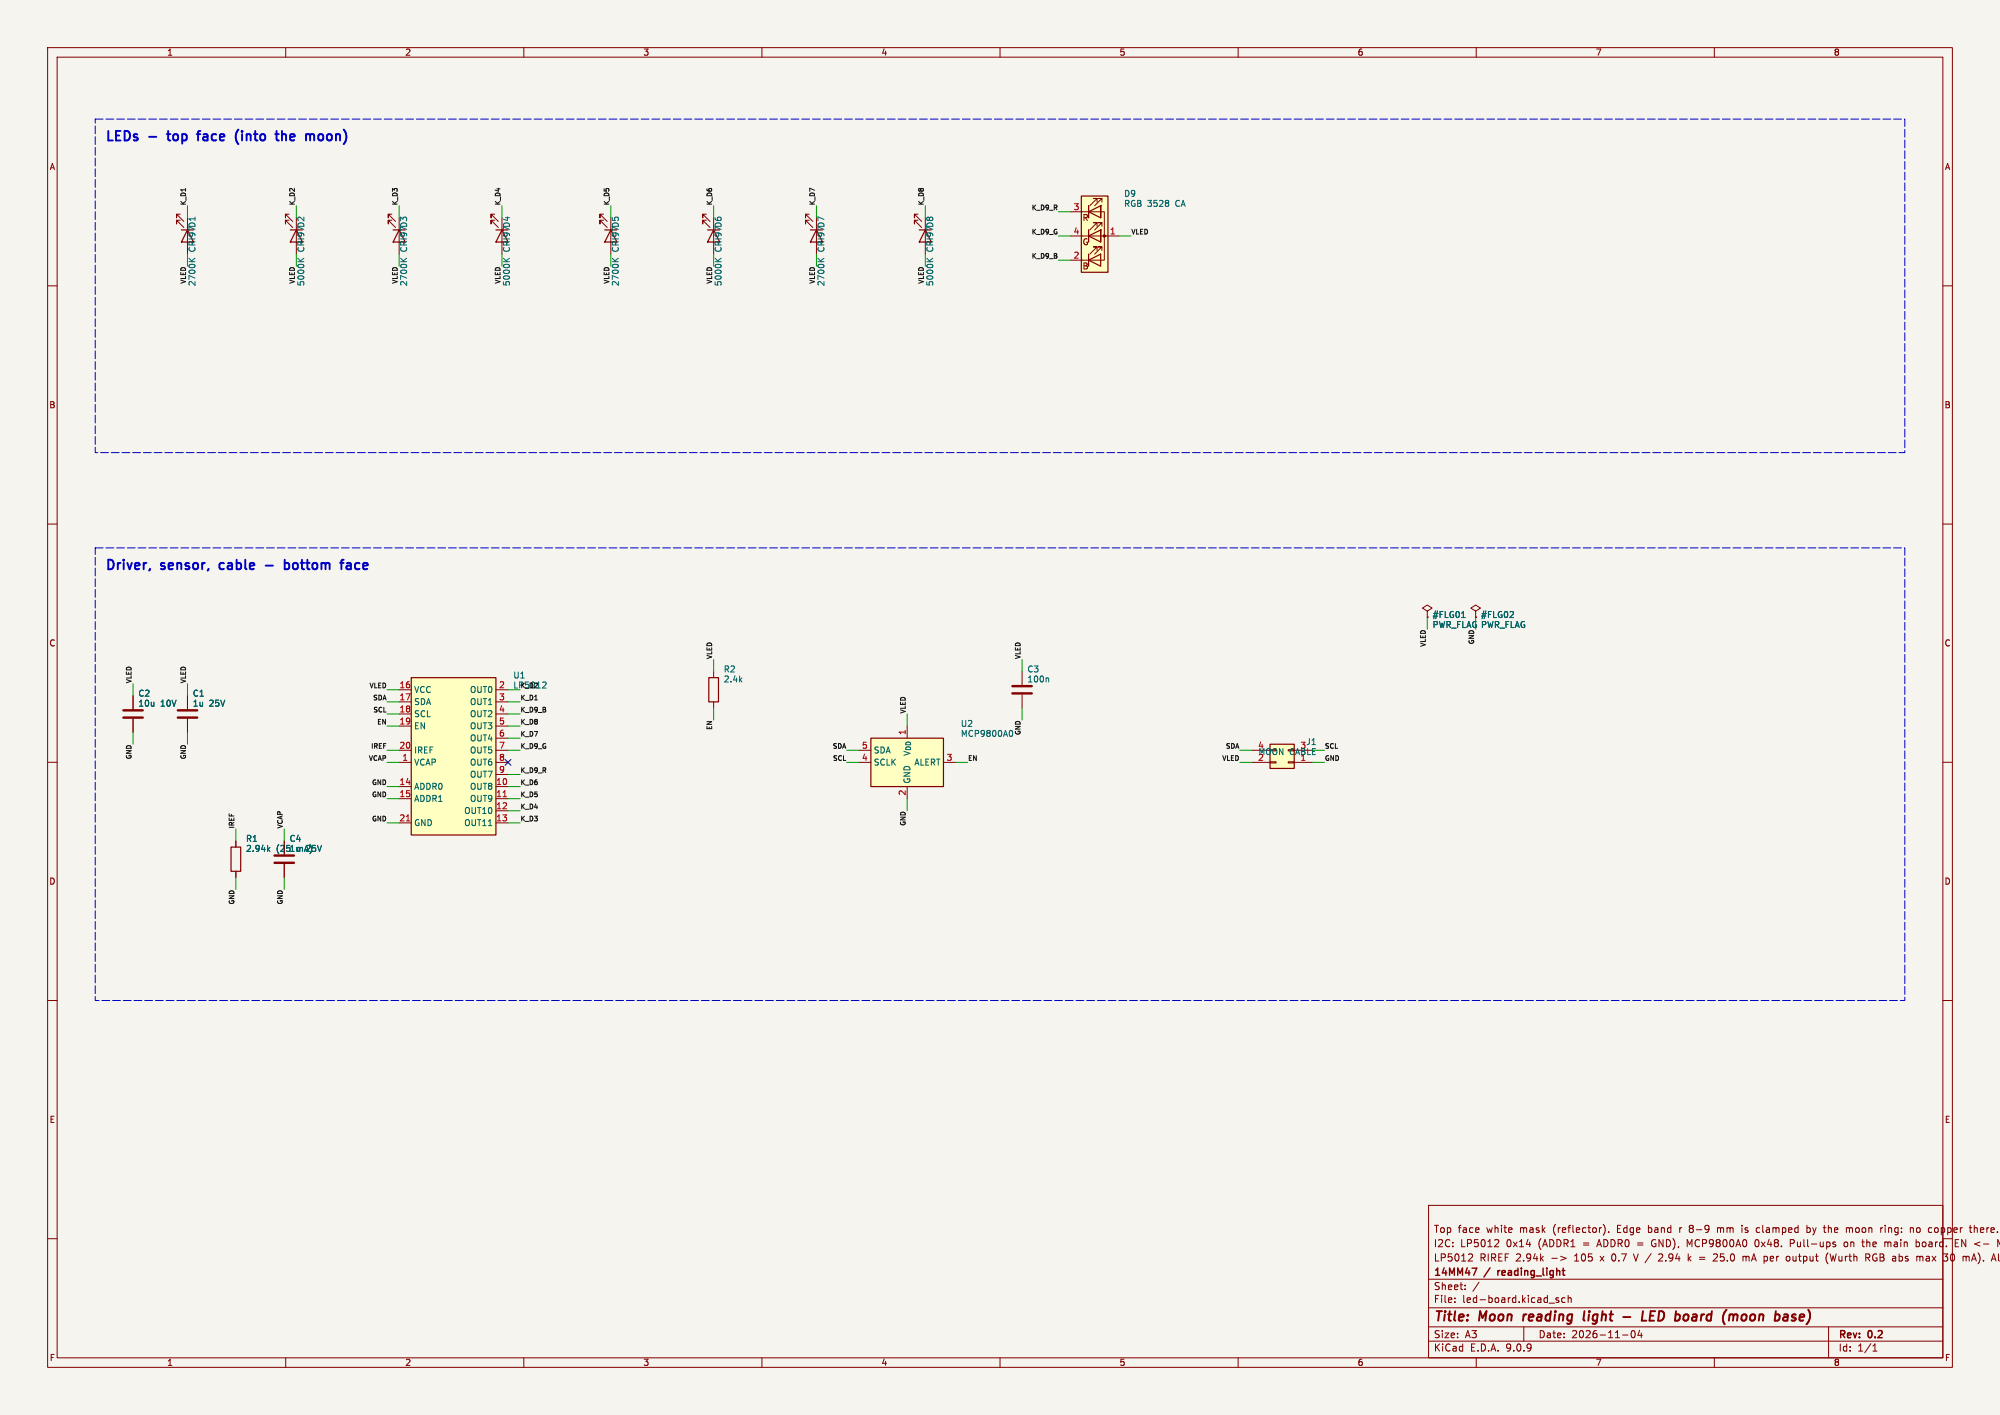
[picture p47: page 1]

LEDs - top face (into the moon) C1

EN K_D6 VLED VLED VLED

IREF Driver, sensor, cable - bottom face
