14MM47/reading_light/deliverable/01-pcb-manufacture/main-board/main-board-schematic.pdf

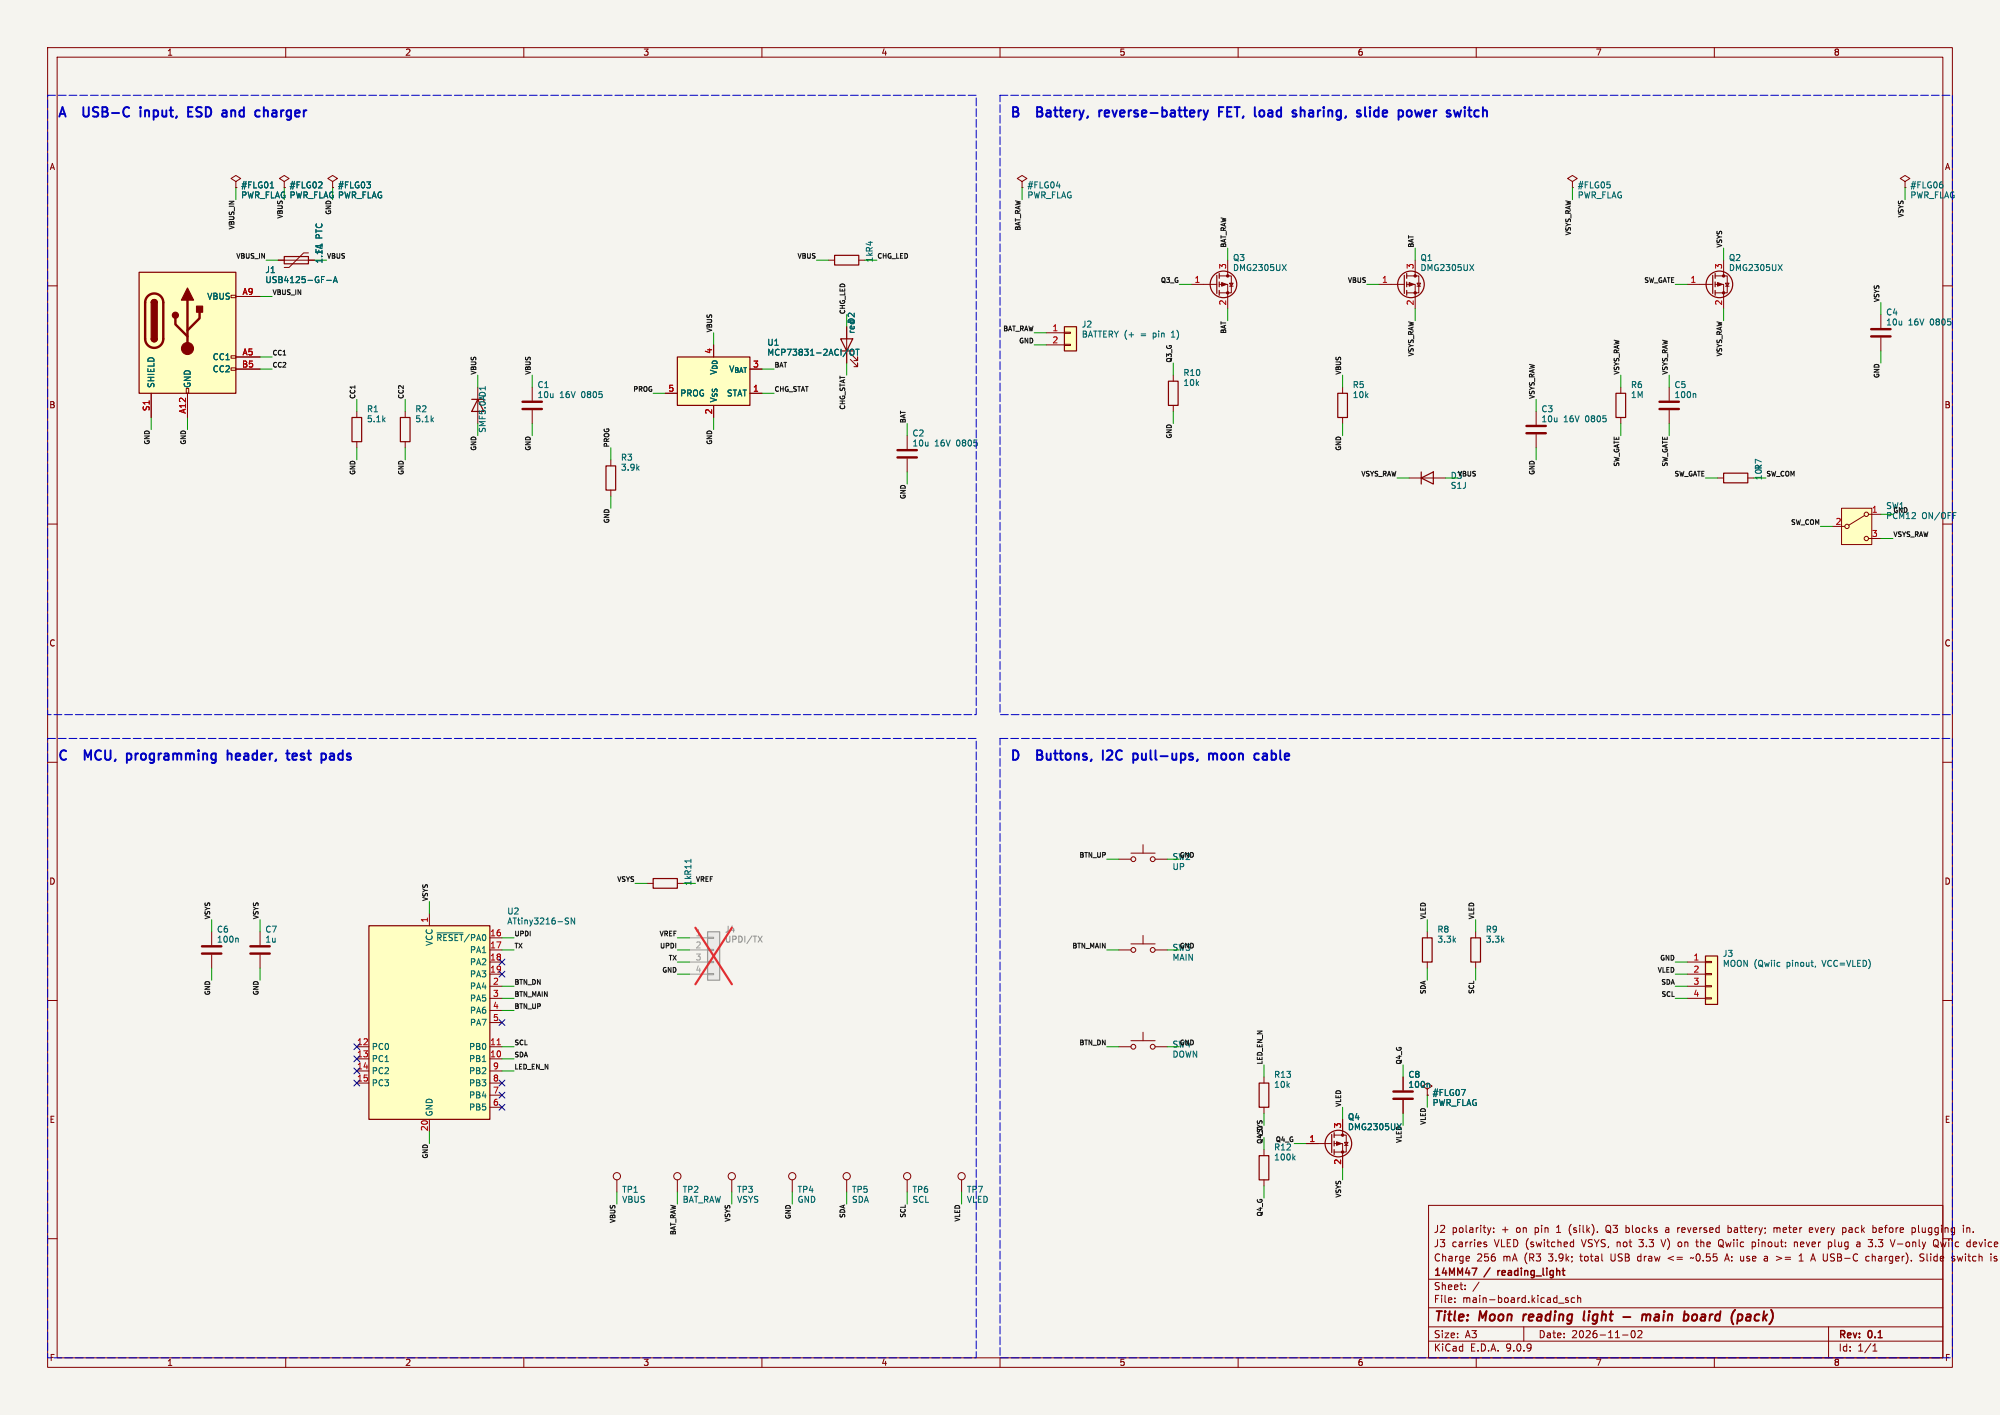
[picture p48: page 1]

Id: 1/1 Title: Moon reading light - main board (pack) File: main-board.kicad_sch Sheet: / 14MM47 / reading_light
