14MM47/reading_light/hardware/led-board/reports/led-board-schematic.pdf

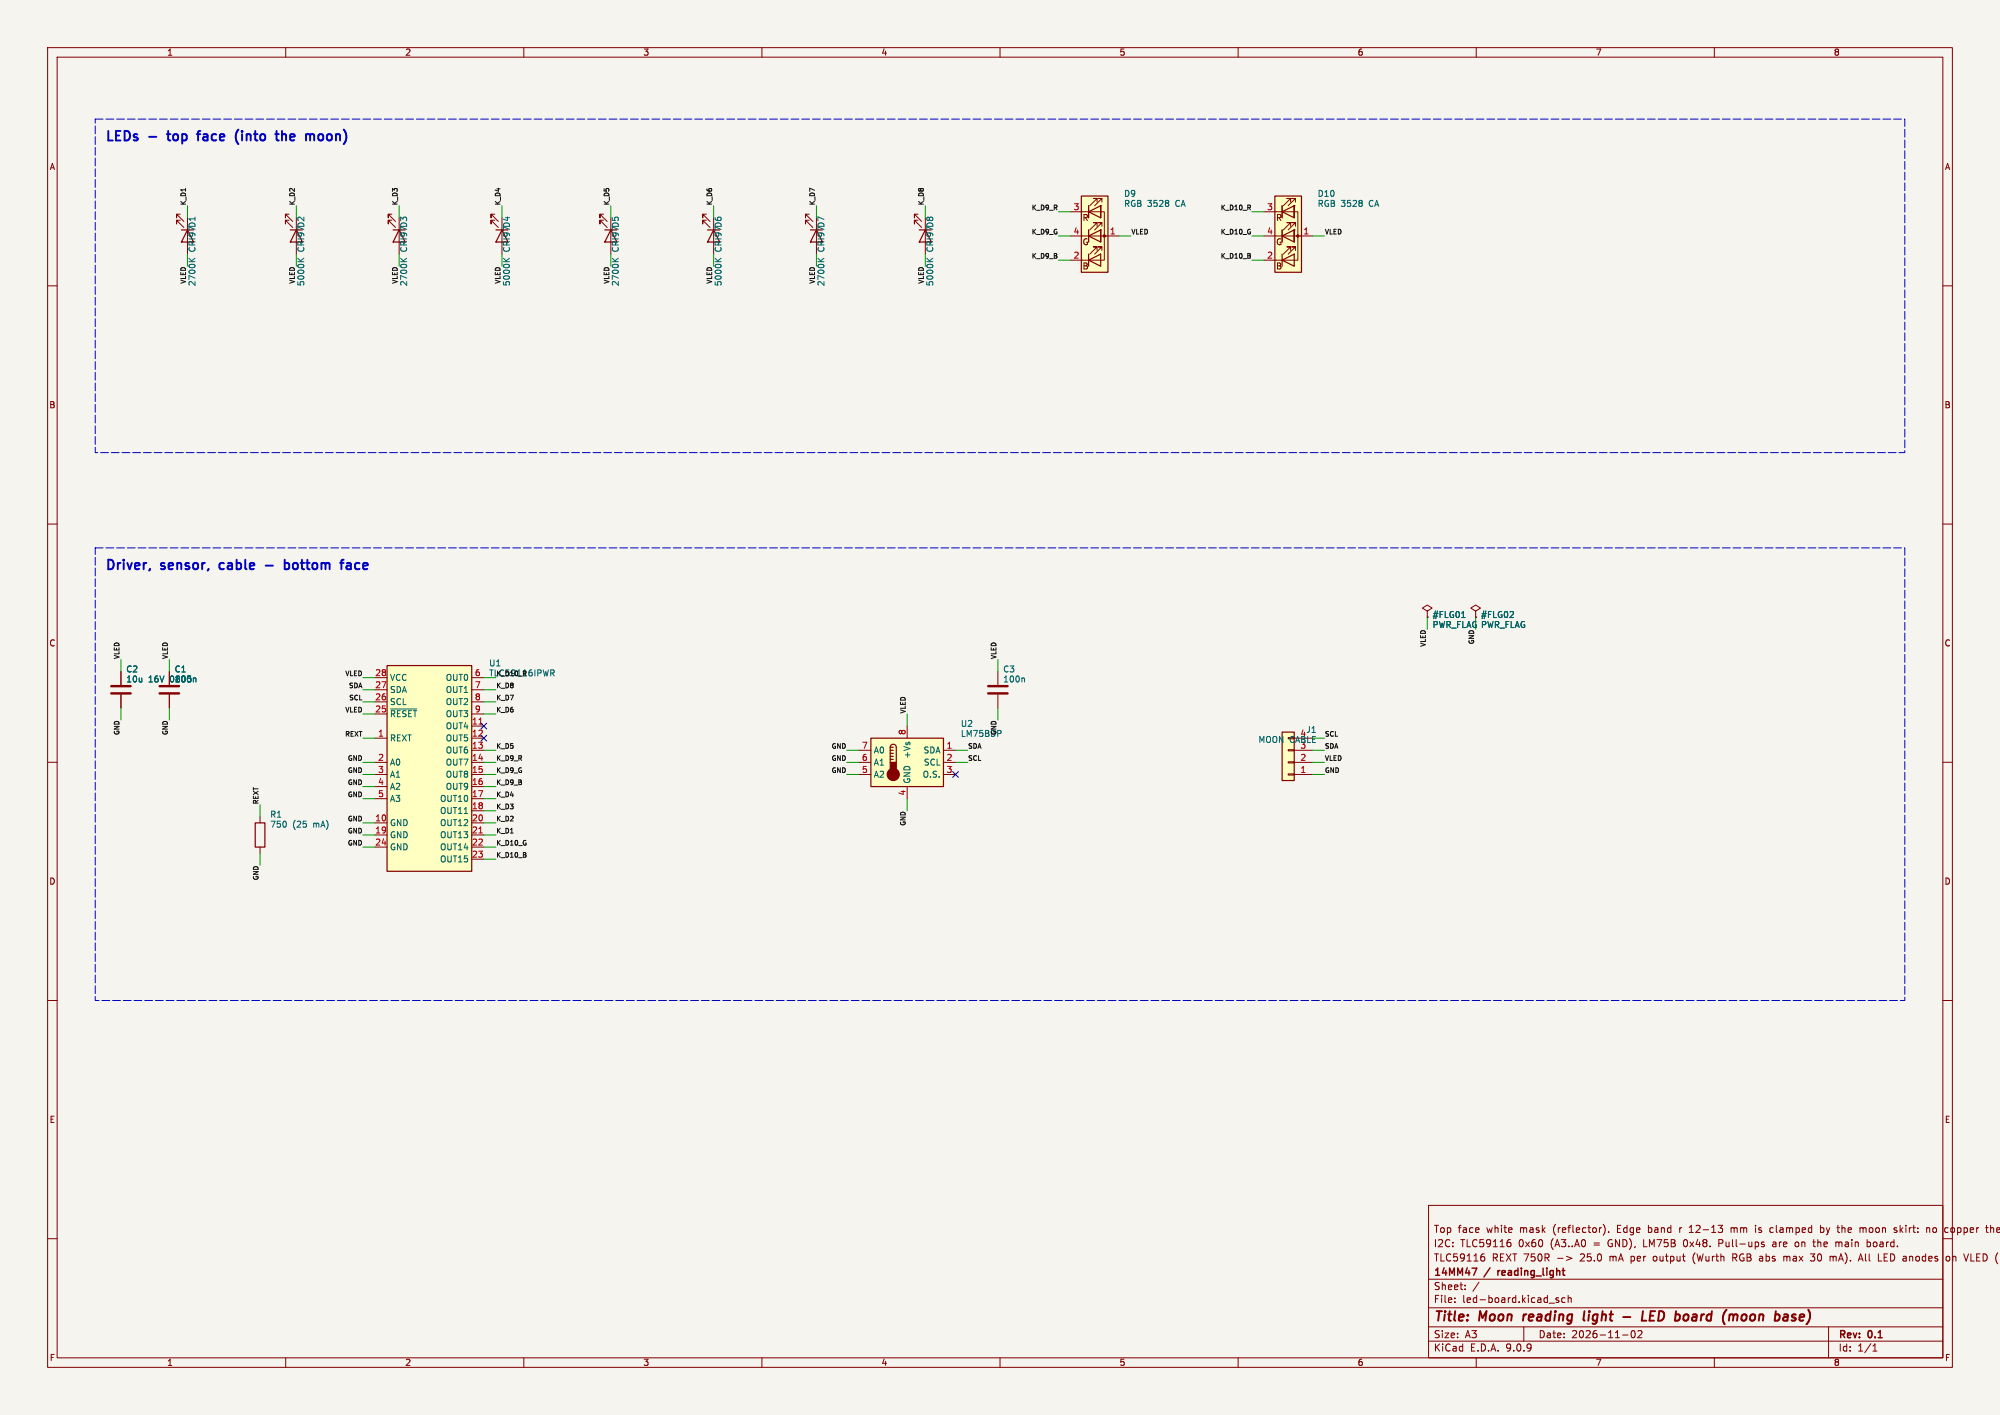
[picture p49: page 1]

LEDs - top face (into the moon)

Driver, sensor, cable - bottom face

K_D5 SDA GND GND GND GND GND GND GND
K_D1 K_D2 K_D3 SCL VLED
