14MM47/reading_light/deliverable/05-assembly-and-bring-up/drawings/led-board_assembly_bottom.pdf

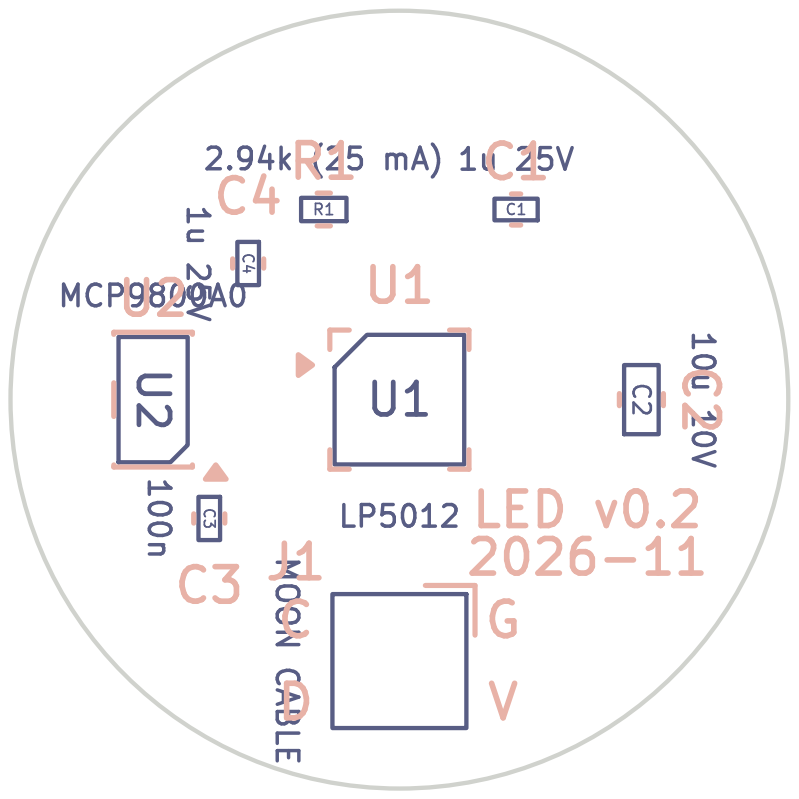
[picture p50: page 1]
