14MM47/reading_light/deliverable/01-pcb-manufacture/kicad-source/led-board/led-board.kicad_pcb

## KiCad design deliverable/01-pcb-manufacture/kicad-source/led-board/led-board.kicad_pcb (2026-11-04)

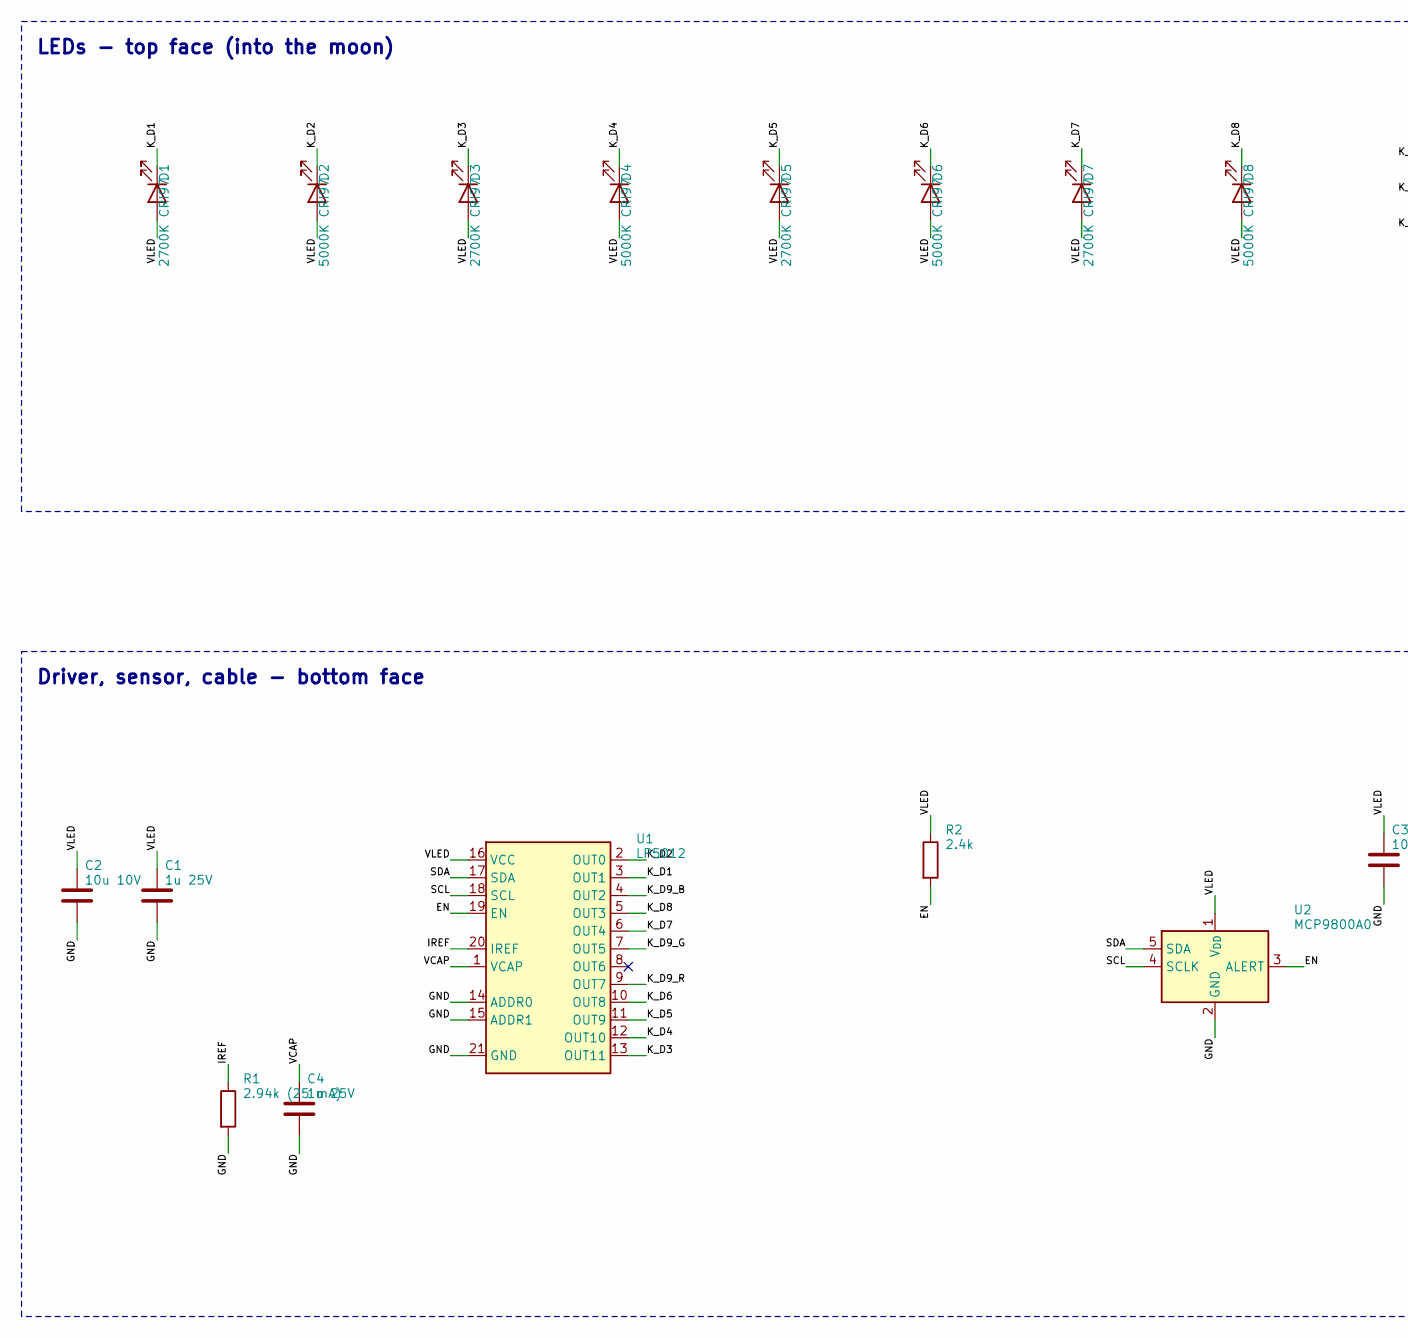
[picture p54: schematic led-board.kicad_sch, Moon reading light - LED board (moon base), part in row 1, column 1]

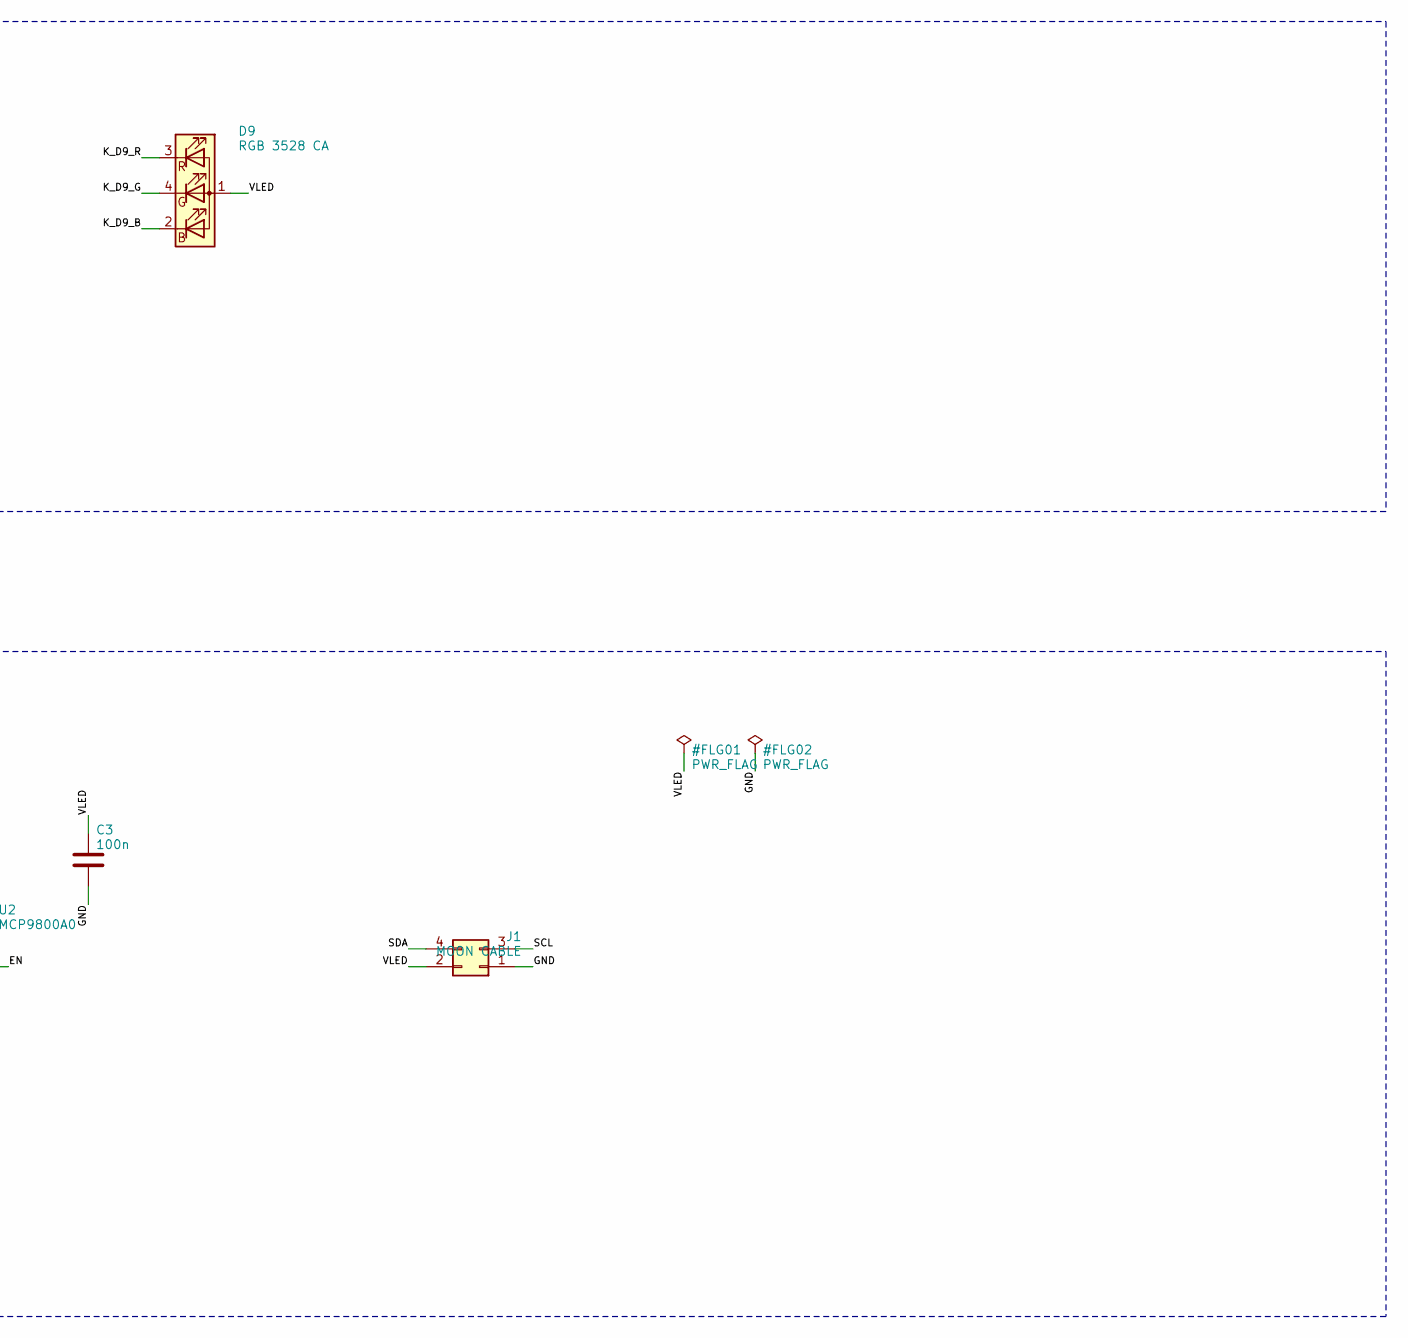
[picture p55: schematic led-board.kicad_sch, Moon reading light - LED board (moon base), part in row 1, column 2]

Parts:
C1, C4: 1u 25V; C_0402_1005Metric; MPN GRM155R61E105KA12D
C2: 10u 10V; C_0603_1608Metric; MPN GRM188R61A106KE69D
C3: 100n; C_0402_1005Metric; MPN GRM155R71C104KA88D
D1, D3, D5, D7: 2700K CRI97; LED_PLCC_2835_Dense; MPN BXEN-27S-11M-3C-00-0-3; Farnell 3498849
D2, D4, D6, D8: 5000K CRI97; LED_PLCC_2835_Dense; MPN BXEN-50S-11M-3C-00-0-3; Farnell 3498853
D9: RGB 3528 CA; LED_RGB_Wuerth-PLCC4_3.2x2.8mm_150141M173100; MPN 150141M173100; Farnell 2322115
J1: MOON CABLE; LED_WirePads_2x02_P1.90mm
R1: 2.94k (25 mA); R_0402_1005Metric; MPN RC0402FR-072K94L
R2: 2.4k; R_0402_1005Metric; MPN RC0402FR-072K4L
U1: LP5012; Texas_RUK0020B_WQFN-20-1EP_3x3mm_P0.4mm_EP1.7x1.7mm; MPN LP5012RUKR
U2: MCP9800A0; SOT-23-5; MPN MCP9800A0T-M/OT; Farnell 1439485

Connections:
/EN: R2.2, U1.19 (EN), U2.3 (ALERT)
/GND: C1.2, C2.2, C3.2, C4.2, J1.1, R1.2, U1.14 (ADDR0), U1.15 (ADDR1), U1.21 (GND), U2.2 (GND)
/IREF: R1.1, U1.20 (IREF)
/K_D1: D1.1 (K), U1.3 (OUT1)
/K_D2: D2.1 (K), U1.2 (OUT0)
/K_D3: D3.1 (K), U1.13 (OUT11)
/K_D4: D4.1 (K), U1.12 (OUT10)
/K_D5: D5.1 (K), U1.11 (OUT9)
/K_D6: D6.1 (K), U1.10 (OUT8)
/K_D7: D7.1 (K), U1.6 (OUT4)
/K_D8: D8.1 (K), U1.5 (OUT3)
/K_D9_B: D9.2 (BK), U1.4 (OUT2)
/K_D9_G: D9.4 (GK), U1.7 (OUT5)
/K_D9_R: D9.3 (RK), U1.9 (OUT7)
/SCL: J1.3, U1.18 (SCL), U2.4 (SCLK)
/SDA: J1.4, U1.17 (SDA), U2.5 (SDA)
/VCAP: C4.1, U1.1 (VCAP)
/VLED: C1.1, C2.1, C3.1, D1.2 (A), D2.2 (A), D3.2 (A), D4.2 (A), D5.2 (A), D6.2 (A), D7.2 (A), D8.2 (A), D9.1 (A), J1.2, R2.1, U1.16 (VCC), U2.1 (V_{DD})

Notes on the sheet:
LEDs - top face (into the moon)
Driver, sensor, cable - bottom face

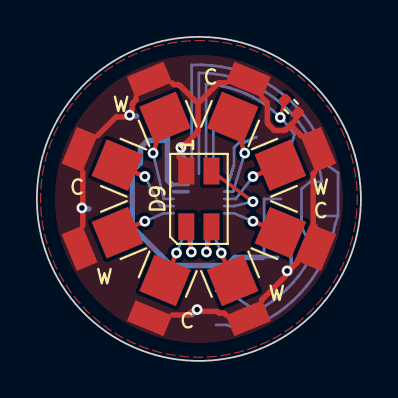
[picture p56: board led-board.kicad_pcb from above]

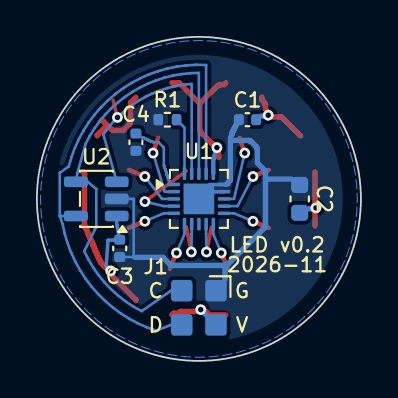
[picture p57: board led-board.kicad_pcb from below]

Board: 2 copper layers, 18.0 x 18.0 mm, 18 parts (8 on the bottom side), 18 nets.
