14MM47/reading_light/deliverable/01-pcb-manufacture/kicad-source/main-board/main-board.kicad_pcb

## KiCad design deliverable/01-pcb-manufacture/kicad-source/main-board/main-board.kicad_pcb (2026-11-02)

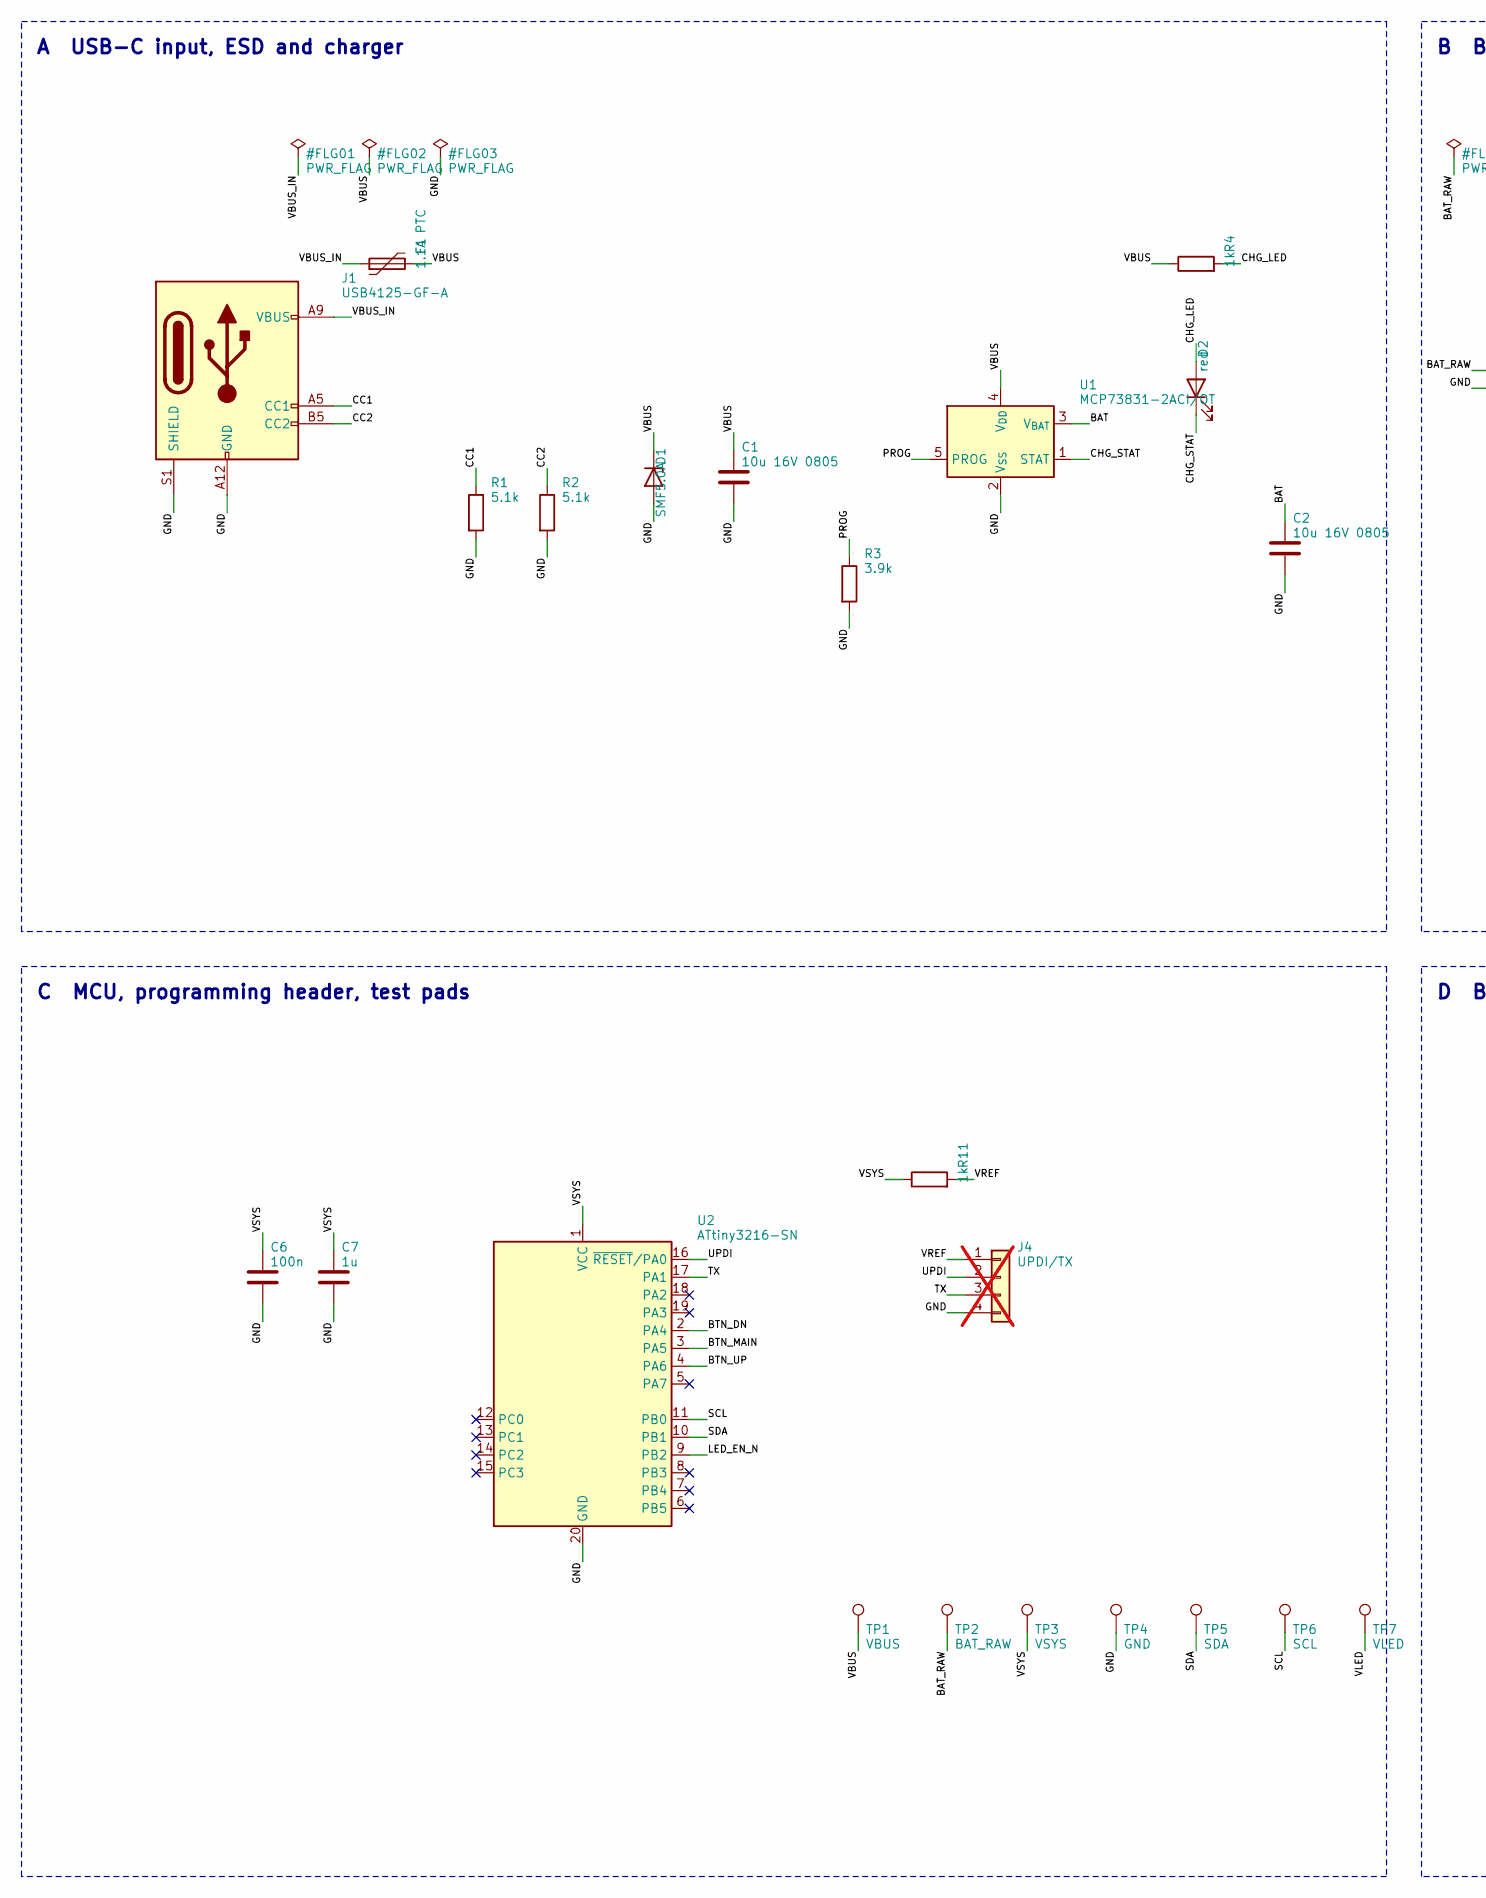
[picture p58: schematic main-board.kicad_sch, Moon reading light - main board (pack), part in row 1, column 1]

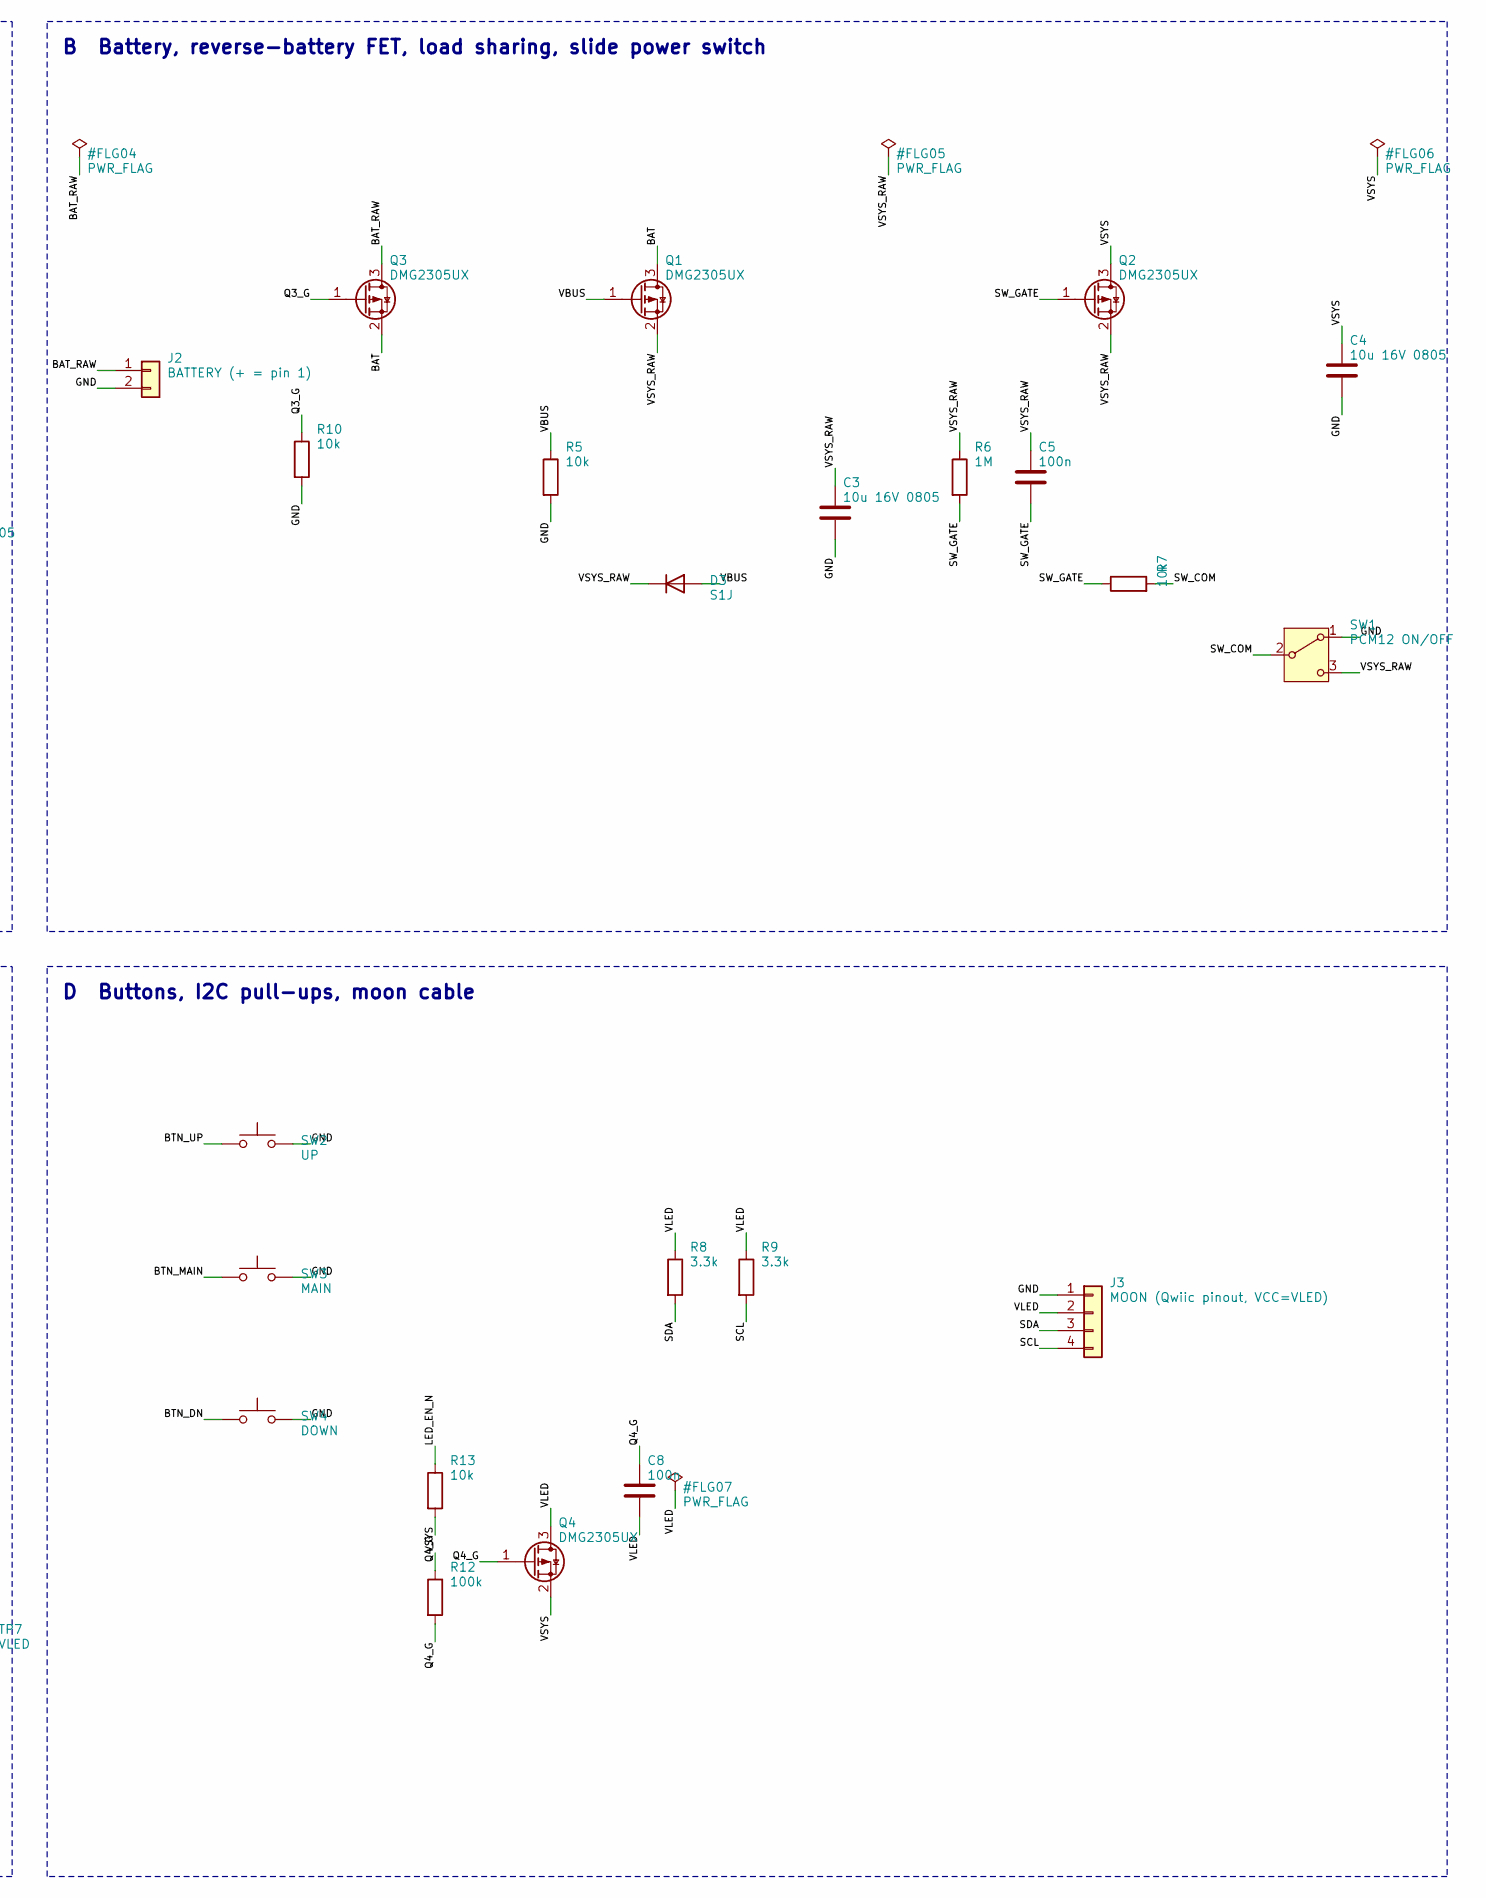
[picture p59: schematic main-board.kicad_sch, Moon reading light - main board (pack), part in row 1, column 2]

Parts:
C1, C2, C3, C4: 10u 16V 0805; C_0805_2012Metric; MPN CL21A106KOQNNNE
C5, C6, C8: 100n; C_0603_1608Metric; MPN MC0603B104K500CT; Farnell 1759122
C7: 1u; C_0603_1608Metric; MPN CL10A105KB8NNNC; Farnell 3013385
D1: SMF5.0A; D_SOD-123F; MPN SMF5.0A; Farnell 2691565
D2: red; LED_0603_1608Metric; MPN APT1608SURCK
D3: S1J; D_SMA; MPN S1J-E3/61T
F1: 1.1A PTC; Fuse_1812_4532Metric; MPN MF-MSMF110/16X-2
J1: USB4125-GF-A; USB_C_Receptacle_GCT_USB4125-xx-x_6P_TopMnt_Horizontal; MPN USB4125-GF-A; Farnell 3648642
J2: BATTERY (+ = pin 1); JST_PH_S2B-PH-SM4-TB_1x02-1MP_P2.00mm_Horizontal; MPN S2B-PH-SM4-TB(LF)(SN); Farnell 9492615
J3: MOON (Qwiic pinout, VCC=VLED); JST_SH_SM04B-SRSS-TB_1x04-1MP_P1.00mm_Horizontal; MPN SM04B-SRSS-TB(LF)(SN); Farnell 1830839
J4: UPDI/TX; PinHeader_1x04_P2.54mm_Vertical; MPN DNP; not fitted
Q1, Q2, Q3, Q4: DMG2305UX; SOT-23; MPN DMG2305UX-7; Farnell 2543533
R1, R2: 5.1k; R_0603_1608Metric; MPN MCWR06X5101FTL
R3: 3.9k; R_0603_1608Metric; MPN MCWR06X3901FTL
R4, R11: 1k; R_0603_1608Metric; MPN MCWR06X1001FTL
R5, R7, R10, R13: 10k; R_0603_1608Metric; MPN MCWR06X1002FTL; Farnell 2447230
R6: 1M; R_0603_1608Metric; MPN MCWR06X1004FTL
R8, R9: 3.3k; R_0603_1608Metric; MPN MCWR06X3301FTL
R12: 100k; R_0603_1608Metric; MPN MCWR06X1003FTL
SW1: PCM12 ON/OFF; SW_SPDT_PCM12; MPN PCM12SMTR; Farnell 9575146
SW2: UP; SW_SPST_PTS645Sx43SMTR92; MPN PTS645SM43SMTR92 LFS; Farnell 3941596
SW3: MAIN; SW_SPST_PTS645Sx43SMTR92; MPN PTS645SM43SMTR92 LFS; Farnell 3941596
SW4: DOWN; SW_SPST_PTS645Sx43SMTR92; MPN PTS645SM43SMTR92 LFS; Farnell 3941596
TP1: VBUS; TestPoint_Pad_D1.5mm
TP2: BAT_RAW; TestPoint_Pad_D1.5mm
TP3: VSYS; TestPoint_Pad_D1.5mm
TP4: GND; TestPoint_Pad_D1.5mm
TP5: SDA; TestPoint_Pad_D1.5mm
TP6: SCL; TestPoint_Pad_D1.5mm
TP7: VLED; TestPoint_Pad_D1.5mm
U1: MCP73831-2ACI/OT; SOT-23-5; MPN MCP73831T-2ACI/OT; Farnell 1332158
U2: ATtiny3216-SN; SOIC-20W_7.5x12.8mm_P1.27mm; MPN ATTINY3216-SN; Farnell 3018703

Connections:
/BAT: C2.1, Q1.3 (D), Q3.2 (S), U1.3 (V_{BAT})
/BAT_RAW: J2.1, Q3.3 (D), TP2.1
/BTN_DN: SW4.1, U2.2 (PA4)
/BTN_MAIN: SW3.1, U2.3 (PA5)
/BTN_UP: SW2.1, U2.4 (PA6)
/CC1: J1.A5 (CC1), R1.1
/CC2: J1.B5 (CC2), R2.1
/CHG_LED: D2.2 (A), R4.2
/CHG_STAT: D2.1 (K), U1.1 (STAT)
/GND: C1.2, C2.2, C3.2, C4.2, C6.2, C7.2, D1.2 (A), J1.A12 (GND), J1.B12 (GND), J1.S1 (SHIELD), J2.2, J3.1, J4.4, R1.2, R2.2, R3.2, R5.2, R10.2, SW1.1 (A), SW2.2, SW3.2, SW4.2, TP4.1, U1.2 (V_{SS}), U2.20 (GND)
/LED_EN_N: R13.1, U2.9 (PB2)
/PROG: R3.1, U1.5 (PROG)
/Q3_G: Q3.1 (G), R10.1
/Q4_G: C8.1, Q4.1 (G), R12.2, R13.2
/SCL: J3.4, R9.2, TP6.1, U2.11 (PB0)
/SDA: J3.3, R8.2, TP5.1, U2.10 (PB1)
/SW_COM: R7.2, SW1.2 (B)
/SW_GATE: C5.2, Q2.1 (G), R6.2, R7.1
/TX: J4.3, U2.17 (PA1)
/UPDI: J4.2, U2.16 (~RESET/PA0)
/VBUS: C1.1, D1.1 (K), D3.2 (A), F1.2, Q1.1 (G), R4.1, R5.1, TP1.1, U1.4 (V_{DD})
/VBUS_IN: F1.1, J1.A9 (VBUS), J1.B9 (VBUS)
/VLED: C8.2, J3.2, Q4.3 (D), R8.1, R9.1, TP7.1
/VREF: J4.1, R11.2
/VSYS: C4.1, C6.1, C7.1, Q2.3 (D), Q4.2 (S), R11.1, R12.1, TP3.1, U2.1 (VCC)
/VSYS_RAW: C3.1, C5.1, D3.1 (K), Q1.2 (S), Q2.2 (S), R6.1, SW1.3 (C)

Notes on the sheet:
A USB-C input, ESD and charger
B Battery, reverse-battery FET, load sharing, slide power switch
C MCU, programming header, test pads
D Buttons, I2C pull-ups, moon cable

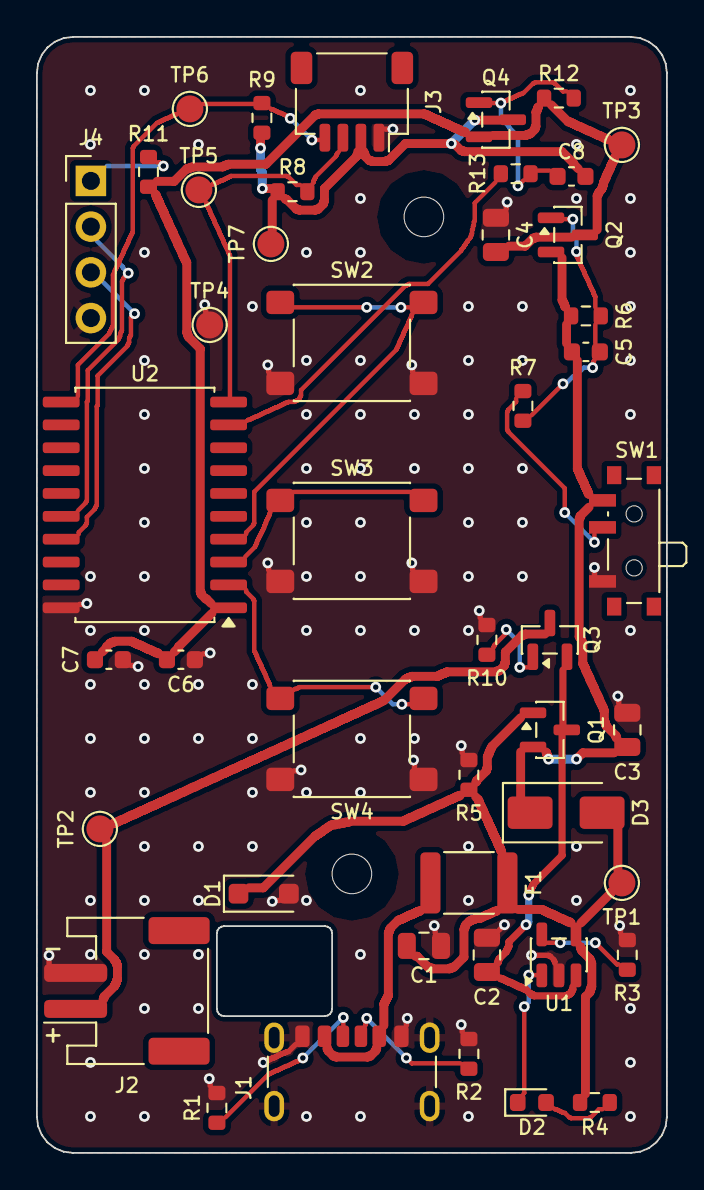
[picture p60: board main-board.kicad_pcb from above]

Board: 2 copper layers, 35.0 x 62.0 mm, 48 parts (0 on the bottom side), 26 nets.

Other parts of the board:
H1, H2: hole
