14MM47/reading_light/(commit log)

2026-11-02 Reading light: generated KiCad boards, firmware, moon lithophane, optics model
    - hardware/: kigen toolchain (schematic writer, pcbnew board builder, 2-layer A* router),
    main board (USB-C charge, reverse-battery + load-share + slide-switch FETs, ATtiny3216,
    3 buttons) and 26 mm LED board (8x CRI97 2835 whites, 2x RGB, TLC59116, LM75BDP);
    both ERC/DRC clean with schematic parity
    - firmware/: PlatformIO/megaTinyCore, portable light core with 17 host unit tests;
    colour-mixing mode table generated from LED chromaticities
    - cad/: local 3dprint-contract pipeline and NASA-data lithophane moon (PASS)
    - docs/design/optics: integrating-sphere model for LED placement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
    [led-board.kicad_pcb, led-board.kicad_sch, main-board.kicad_pcb, main-board.kicad_sch, sphere_illum.csv]
2026-11-02 CAD: moon base cup, pack front/back, clip, button caps; checker bridges + ray-cast renders; docs
    - moon_base: LED-board pocket + ledge, helical-cam bayonet, M10x1 nut socket, cable notch
    - pack_front/back/clip/caps read button, connector and mounting positions from hardware/main-board/design.py
    - pipeline: flat ceilings <= bridge_max are bridges (3dprint PLAN 4.4), depth-cued ray-cast renders
    - PLAN.md (requirements, architecture, decision log), README, CLAUDE.md, research notes
    Claude-Session: https://claude.ai/code/session_01VUrRnWdko2sTDN56TwgM6A
2026-11-02 Docs: electronics calculations, moon and assembly previews, BOM/order generator, Thingiverse handoff
    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
    [BOM.csv, farnell_order.csv, other_purchases.csv]
2026-11-02 Verification round 1 fixes, fab packages, print files, handoffs
    Electronics (both boards regenerated: ERC 0, DRC 0 errors, 0 unconnected,
    0 parity):
    - Q4 MCU-switched LED-board supply (PB2), I2C pull-ups moved to VLED.
    - F1 PTC ahead of the TVS, R3 3.9k (256 mA charge), R5 10k, J4.1 = VREF via 1k.
    - LM75B OS drives TLC59116 RESET as a hardware thermostat.
    - LED board 1.0 mm in the board file; project LM75BDP symbol (no ERC
    lib mismatch).
    - Router keeps the full track body out of rule areas and clears NPTH.
    - Reference placement uses measured text size, existing silk and slots.
    Firmware (25 host tests pass, all envs build):
    - LED-board power control, LM75B Tos/Thyst programming and re-arm.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
    [BOM.csv, bom_jlcpcb.csv, bom_pcbway.csv, button_caps.3mf, button_caps.stl, coupon_bayonet.3mf, coupon_bayonet.stl, coupon_fit.3mf]
2026-11-02 Verification round 2: fit and assembly blockers, Q4 soft start, firmware fixes
    Two independent reviewers re-checked round 1 (electrical/firmware and
    DFM/fit). All round-1 fixes confirmed; new findings fixed:
    Hardware (both boards regenerated: ERC 0, DRC 0 errors, 0 unconnected,
    - Main board:
    - Battery-lead slot 6.4 x 5.0 mm, so the pre-fitted cell plug passes.
    - Q4 soft turn-on (R13 10k, C8 100n gate-drain) so the LED board's
    inrush no longer sags the MCU supply.
    - F1 is now MF-MSMF110/16X; TP7 VLED test pad.
    - LED board:
    - RESET pull-up 2.4k.
    - W/C silk letters beside the white LEDs.
    - Generator:
    - Title block, values on Fab, DNP cross-out.
    - Outward reference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
    [BOM.csv, bom_jlcpcb.csv, bom_pcbway.csv, button_caps.3mf, button_caps.stl, coupon_bayonet.3mf, coupon_bayonet.stl, coupon_fit.3mf]
2026-11-02 Add the deliverable generator (tools/build_deliverable.py)
    Assembles deliverable/ in build order (overview, PCB manufacture, parts
    order, 3D printing, firmware, assembly, verification, design reference).
    It copies fab/, print/, bom/ and the PlatformIO hex files, renders every
    handoff, checklist and report to PDF (pandoc + Chromium), and writes a
    SHA-256 manifest. README, CLAUDE.md and PLAN point to it.
    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
2026-11-02 Generate deliverable/ build pack from 67f9752
    131 files in build order:
    - 00 overview
    - 01 PCB manufacture: Gerber zips, fab notes, STEP, schematics, assembly
    service files, KiCad source
    - 02 parts order
    - 03 3D printing: STL + 3MF + previews, grouped by print batch
    - 04 firmware: release, debug and bench hex, plus source zip
    - 05 assembly drawings, schematics and images
    - 06 verification checklist and reviewer reports
    - 07 design reference
    36 PDFs rendered from the docs, plus a SHA-256 MANIFEST.
    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
    [BOM.csv, bom_jlcpcb.csv, bom_pcbway.csv, button_caps.3mf, button_caps.stl, coupon_bayonet.3mf, coupon_bayonet.stl, coupon_fit.3mf]
2026-11-02 Fitment renders: exploded and section views of the pack and the moon head
    cad/tools/fitment.py places every part in its assembled position. It
    renders five labelled views to docs/design/fitment/: exploded pack,
    pack sections through the buttons and through J2, exploded head, and a
    head section through the axis.
    - Printed parts come from cad/parts.
    - The boards come from the generated .kicad_pcb via
    hardware/export_geometry.py: exact outline, slot and holes; component
    bodies are Fab outlines extruded to datasheet heights.
    - Pouch, nut, screws, gooseneck and wires come from the design
    constants.
    Section faces are hatched, and labels snap to visible pixels of their
    part. The deliverable g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
2026-11-03 LED board v0.2: LP5012 driver, 18 mm board, one centred RGB, MCP9800 thermostat
    - TI LP5012 (WQFN-20, 3x3 mm) replaces the TLC59116 (TSSOP-28): RIREF 2.94k = 25.0 mA/channel,
    ADDR1/0 = GND (0x14), EN held low by the sensor's open-drain ALERT (hardware thermostat), 2.4k pull-up.
    - 8 CRI-97 whites radial on a 5.8 mm ring, cathode inward; one Wurth RGB at the centre; board 26 -> 18 mm.
    Project footprint LED_PLCC_2835_Dense (KiCad land pattern, IPC level-C 0.1 mm courtyard) lets the eight
    2835s sit on that ring without courtyard overlap.
    - Sensor: Microchip MCP9800A0 (SOT-23-5, LM75-compatible registers, 0x48). The LM75BDP TSSOP-8 did not
    fit, and the TMP1075's pin order (SDA, SCL, ALERT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
    [bom_jlcpcb.csv, bom_pcbway.csv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]
2026-11-03 Firmware for LED board v0.2: LP5012 driver layer, MCP9800 thermostat, one RGB
    - LP5012 (0x14): DEVICE_CONFIG0 Chip_EN, CONFIG1 0x1C (linear scale, power save, auto-increment,
    dithering, 25.5 mA option), no bank control; one 16-byte write covers the four LEDx_BRIGHTNESS
    and twelve OUTx_COLOR registers. Re-initialised whenever Chip_EN reads 0 (POR, or the thermostat
    cycling EN); RESET register (17h) before a recovery power-cycle.
    - lib/core: lp_brightness / lp_colour replace the TLC59116 IREF steps. Duty = colour x brightness;
    one brightness for all banks (each bank mixes groups), the smallest that shows the strongest group,
    with hysteresis; writes ordered so the in-between state is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
    [config.h, main.cpp]
2026-11-03 Moon head v0.2: inside-stem cup for the 18 mm LED board, corrected optics model, BOM split
    - moonlib/moon_shell/moon_base/moon_ring/coupon_bayonet/jig_led_board rebuilt around the
    18 mm LP5012 board: cup 20.8 mm with inverted bayonet (lugs 22.4 mm), moon skirt 25.3 mm,
    0.8 mm clamp ring, LEDs 1.2 mm below a 9.0 mm opening; all parts PASS, print/ regenerated.
    - Optics: the earlier flare sweep let rays pass through the PLA wall; head_v02.py takes the
    opening as the aperture. As built: 1.011 max/min (one CCT), 1.002 all whites, 1.037 RGB.
    - pipeline: wall sampling skips zero-area faces (unit test in cad/tests).
    - BOM: supplier per line, LP5012 from DigiKey UK (digikey_order.csv), MCP9800A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
    [BOM.csv, button_caps.3mf, coupon_bayonet.3mf, coupon_bayonet.stl, coupon_fit.3mf, coupon_litho_wedge.3mf, digikey_order.csv, farnell_order.csv]
2026-11-03 LED board v0.2: schematic note names the MCP9800 thermostat; assembly routes for the WQFN board
    - design.py docstring and the schematic title-block comment still named the LM75B and the flared bore;
    rebuilt (ERC 0, DRC 0 / 0 unconnected / 0 parity; copper identical, only the note and file order change).
    - assembly_routes.md: the LED board is now WQFN-20 + 0402, so the hand route needs a stencil and a hot
    plate; recommend JLCPCB Economic bottom-side assembly for that board, hand-fit the top.
    - main-board: code comment only (rebuild check: kigen changes still route it clean; files unchanged).
    Claude-Session: https://claude.ai/code/se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
    [led-board-B_Cu.gbl, led-board-B_Mask.gbs, led-board-B_Paste.gbp, led-board-B_Silkscreen.gbo, led-board-Edge_Cuts.gm1, led-board-F_Cu.gtl, led-board-F_Mask.gts, led-board-F_Paste.gtp]
2026-11-03 Docs for LED board v0.2: design note, PLAN, handoffs, MCP9800 key specs; debug log shows lp=/ts=
    - docs/design/led-board-v0.2.md: driver and sensor choice, layout topology, the optics correction, the slim
    head, what changes for the user, cost, VERIFY items.
    - PLAN.md: architecture, optics and mechanics for v0.2, R21 revised for the LED board, decision log 2026-11-03.
    - Handoffs 01-05: 18 mm board specs and stencils, DigiKey LP5012RUKR, MCP9800 stock, the inside-out bayonet,
    LED-board v0.2 assembly (R2 on top, one RGB, diode test from the exposed cathode pad end).
    - KEYSPECS: MCP9800A0 extract (pinout, address, CONFIG bits, conversion time, power-up defaults).
    - Firmware debug build print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
    [main.cpp]
2026-11-03 Deliverable generator: per-board revisions, v0.2 design note, DigiKey list, round 3 slots
    - fab paths from each board's design.py REV (main board v0.1, LED board v0.2); the pack is named
    after the newest board; PDF footers carry the build label (DOC_LABEL) instead of a fixed v0.1.
    - README templates updated for the 18 mm LP5012 board, the slim head and the open decisions.
    - Expects docs/verification/round3.md and round3/*.md (review in progress): regenerate after them.
    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
2026-11-04 Round 3 docs-consistency fixes; bench_tstat_low build for the thermostat check
    - ORDER.md/build_bom.py recommend fab assembly of the LED board's WQFN face (matches assembly_routes,
    handoff 01, R21); three stencils listed.
    - Handoff 02: 0402 substitutes for R1/R2, MCP9802A0T-M/OT as the sensor drop-in.
    - VERIFY E7 limit uses the MCP9800's 0.4 mA max; F5 and E17 use the debug fields that exist; E17 now
    runs with the new bench-only env bench_tstat_low (TSET 30 / THYST 28 C, config.h guards).
    - Design note, PLAN, electronics, README, KEYSPECS: figures and wording corrected (v0.1 basket 44.53,
    TLC current, T2-T4/T6, ring radius, 6500 K at 75 %, LED-board ~6 uF, R19 dither note, tEN_H).
    - ge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
    [other_purchases.csv]
2026-11-04 LED board v0.2: IREF as fixed copper from the pad centres; connection-width DRC rule
    - Round 3 R3-E1: the routed IREF track met U1 pin 20 and R1 pad 1 at their corners (0.106 / 0.129 mm
    copper necks, invisible to DRC). IREF is now fixed copper pad centre to pad centre, and the board
    carries a .kicad_dru connection_width >= 0.15 mm rule (it flags the old joint). ERC 0, DRC 0 / 0
    unconnected / 0 parity.
    - parts.py: MCP9800 accuracy as in DS21909D (+/-0.5 typ, +/-1 max -10..85 C); unused 0603 R_2K4 removed.
    - design.py comments: G V D C, pad corners r 7.88, C4 is the VCAP cap.
    - Round 3 reviewer reports added (electrical/firmware, mechanical/optics); BOM regenerated.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
    [BOM.csv, bom_pcbway.csv, farnell_order.csv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]
2026-11-04 Firmware round 3: safe LP5012 init order, once-a-second register read-back, thermostat hold, warm restart
    - R3-F1: lp_init() configures and zeroes all outputs in STANDBY, sets Chip_EN last.
    - R3-F2: lp_verify() reads CONFIG0/1 and the 16 output registers every second; a config mismatch
    re-inits, an output mismatch forces a full rewrite (a corrupted burst no longer persists).
    - R3-F3: retries rewrite the MCP9800 limits only if they changed, and the power-cycle count stays at
    0 while the thermostat holds EN.
    - R3-F4: any LED-board loss re-arms the 700 ms first-conversion wait (no false 0 C reading).
    - R3-F5: the first valid reading after init sets the derate at once (fades, no 10 %/s slew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
    [main.cpp]
2026-11-04 Moon head round 3: designed clamp spring, clockwise lock, jam nut, split bayonet coupon, stricter wall check
    Round 3 mechanical/optics review (docs/verification/round3/mechanical_optics.md):
    - R3-M1/M2: the locked bayonet was line-to-line. The cup's land now sits 0.4 mm under the board top, so
    the ring rolls over the board edge as a spring (0.23-0.39 mm travel for a 0.9-1.1 mm board), and the
    locked groove floor stands LOCK_OFFSET 0.15 above the lug (0.05-0.25 mm preload); claims check the
    closure for board +/- 0.1. GAP_45 0.25 -> 0.35. LOCK_OFFSET is the knob VERIFY M4 tunes.
    - R3-M3: coupon_bayonet split into coupon_bayonet_cup (PETG 0.16, cut on a real layer boundary) and
    coupon_b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
    [BOM.csv, button_caps.3mf, coupon_bayonet.3mf, coupon_bayonet.stl, coupon_bayonet_cup.3mf, coupon_bayonet_cup.stl, coupon_bayonet_skirt.3mf, coupon_bayonet_skirt.stl]
2026-11-04 Round 3 write-up: dispositions, open decisions, docs for the clamp spring, clockwise lock and jam nut
    - docs/verification/round3.md: every finding of the three reviews with its disposition, what was found
    while fixing (groove-roof lip, north-pole fold, the wall-sampling gap, an optics gradient artefact,
    a test reading past OUT_GROUP), the re-check, and five decisions for Matt.
    - PLAN decision log 2026-11-04; design note, electronics notes, KEYSPECS (colour-register contradiction,
    Wurth derating), VERIFY (E8, E9, E18, T3, O2, O4, M1, M4, M5, M12), handoffs 03-05 for the coupon
    split, the clockwise lock and the two-nut cup.
    - Deliverable generator: round 3 in the overview, open decisio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
2026-11-04 Regenerate deliverable/ from 299c015 (LED board v0.2, slim head, round 3)
    Build pack for main board v0.1 + LED board v0.2: LED board v0.2 Gerbers and fab notes, the split
    bayonet coupons, the round-3 head parts, firmware hex from the round-3 sources (five builds incl. the
    bench thermostat build), DigiKey list, round-3 dispositions and open decisions in 00-overview.
    160 files, 65.5 MB; MANIFEST.txt lists every file with its source.
    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
    [BOM.csv, bom_jlcpcb.csv, bom_pcbway.csv, button_caps.3mf, coupon_bayonet.3mf, coupon_bayonet.stl, coupon_bayonet_cup.3mf, coupon_bayonet_cup.stl]
